StefanSaier-FSM/PowerBors-Wordclock/4_Dokumentation/Label/ReadMe.txt

Das Label kann mit dem Programm Nicelabel 10 gedruckt werden.
