StefanSaier-FSM/PowerBors-Wordclock/4_Dokumentation/Datasheets/PDV-P8104/Online Link.txt

https://www.mouser.de/ProductDetail/Advanced-Photonix/PDV-P8104?qs=tlsG%2FOw5FFhNlJFnM8WslQ%3D%3D
