StefanSaier-FSM/PowerBors-Wordclock/4_Dokumentation/Datasheets/PT1000/Online Link.txt

https://www.mouser.de/ProductDetail/Heraeus-Nexensos/32208571?qs=MQgg6%252BVqoaOBHSlL4FSuWg%3D%3D
