StefanSaier-FSM/PowerBors-Wordclock/4_Dokumentation/Label/Wordclock.png

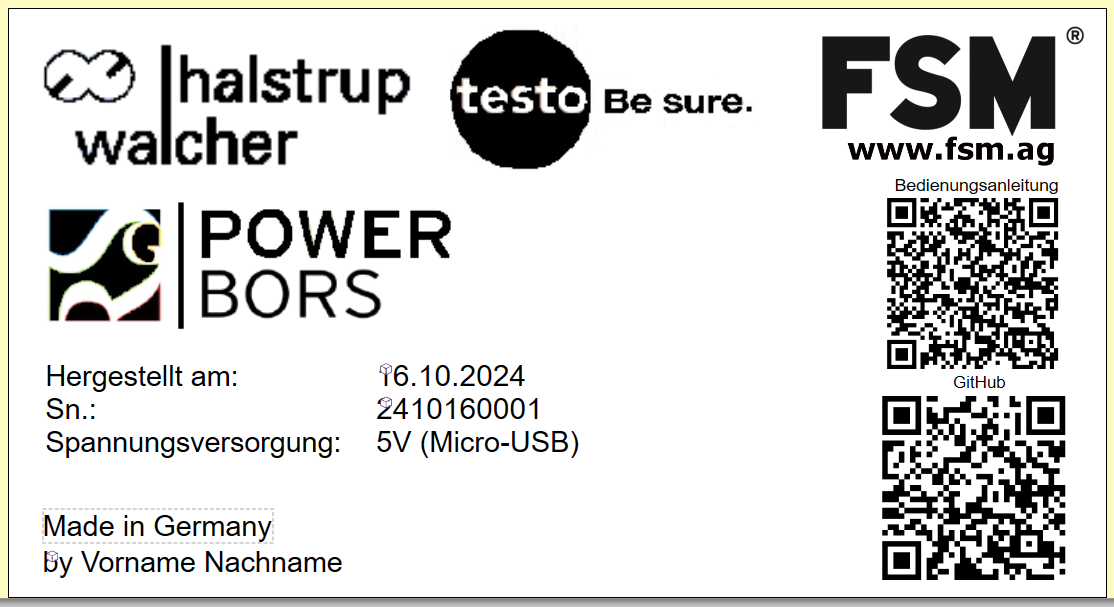
4_Dokumentation/Label/Wordclock.png
