StefanSaier-FSM/PowerBors-Wordclock/1_PCB/17862V2 STL Component Calculation.xlsx

Sheet: BOM Report
Bill of Materials Costing
 |  | Word Clock
Project Number: |  | 17862
Version: |  | V2_1
Variant: |  | A Default
 |  |  | +49 7661 9855 0 |  | www.fsm.ag
Creation Date: | 01.08.2024 | 10:57
Print Date: | 2024-08-01 | 10:57:05
Name: | M.Faller
 |  |  |  |  |  | Stock | Unit Price | Total Price
FSM Part Number | Quantity | Designator | Comment | Footprint | Mounting Technology | Supplier Stock 1 | Supplier Unit Price 1
30096001 | 114 | C0, C1, C2, C3, C4, C5, C6, C7, C8, C9, C10, C11, C12, C13, C14, C15, C16, C17, C18, C19, C20, C21, C22, C23, C24, C25, C26, C27, C28, C29, C30, C31, C32, C33, C34, C35, C36, C37, C38, C39, C40, C41, C42, C43, C44, C45, C46, C47, C48, C49, C50, C51, C52, C53, C54, C55, C56, C57, C58, C59, C60, C61, C62, C63, C64, C65, C66, C67, C68, C69, C70, C71, C72, C73, C74, C75, C76, C77, C78, C79, C80, C81, C82, C83, C84, C85, C86, C87, C88, C89, C90, C91, C92, C93, C94, C95, C96, C97, C98, C99, C100, C101, C102, C103, C104, C105, C106, C107, C108, C109, C110, C111, C112, C113 | 100n | C1206 | SMT | 0 |  | 0.00
30339601 | 2 | C114, C116 | 100n | C_THT_RM5.08_L7_B4 | THT |  |  | 0.00
xxxxxx01 | 2 | C115, C117 | 1µ | C_THT_RM5.08_L7_B4 | THT |  |  | 0.00
30045701 | 2 | D1, D4 | 1N4004 | DO-41_RM10.16_THT | THT | 0 |  | 0.00
40136001 | 2 | D2, D3 | 1N4448 | DO-35_RM10.16_THT_RED | THT | 0 |  | 0.00
30097701 | 2 | IC2, IC4 | LM317TG | TO220-3 THT | THT |  |  | 0.00
30031401 | 2 | IC3, IC6 | LM358N | PDIP8 THT | THT | 0 |  | 0.00
30426601 | 2 | R1, R9 | 2K | R_THT_RM10.16 | THT |  |  | 0.00
30002501 | 2 | R2, R10 | 2k21 | R_THT_RM10.16 | THT | 0 |  | 0.00
30045601 | 3 | R3, R15, R16 | 1k | R_THT_RM10.16 | THT |  |  | 0.00
30005301 | 1 | R4 | BQ7721603 | RJ-5EW | THT | 0 |  | 0.00
30037201 | 4 | R5, R6, R7, R14 | 10k | R_THT_RM10.16 | THT |  |  | 0.00
30019501 | 1 | R8 | 10k | R_THT_RM10.16 | THT |  |  | 0.00
30xxxx01 | 1 | R11 | BQ7721603 | LDR | THT | 0 |  | 0.00
30xxxx01 | 1 | R12 | BQ7721603 | PT1000 | THT | 0 |  | 0.00
30005101 | 1 | R13 | 2K | RJ-5EW | THT |  |  | 0.00
30xxxx01 | 2 | S1, S2 | BQ7721603 | Schiebeschalter THT 0S202011MA0QN1 | THT | 0 |  | 0.00
30738801 | 1 | ST1 | USB-A 87583-2010 | ST_USB_87583-2010 | SMT |  |  | 0.00
30445401 | 2 | ST2, ST4 | ST_1Pol_30212_AWG16_ROT | ST_1Pol_THT_SP_AWG16 | THT | 0 |  | 0.00
30066301 | 1 | ST3 | TSW-104-07-F-S | ST_SL_2_54_4Pol_THT | THT |  |  | 0.00
30527001 | 1 | ST5 | USB-B Micro | ST_USB_629105136821 | SMT |  |  | 0.00
30279101 | 3 | SW1, SW2, SW3 | SKHLLFA010 | SW_SKHL_6x3.5mm | THT |  |  | 0.00
 | 152 | Total Number of Components |  |  |  |  | Total Price | 0.00
 | 22 | Total Number of Different Components

Sheet: Project Information
Project Full Path | W:\Ausbildung\Technische Ausbildungsprojekte\17862_Wordclock\PowerBors\2_CAD\V2\PCB_Project_WordClock.PrjPcb
Project Filename | PCB_Project_WordClock.PrjPcb
Variant Name | A Default
Data-Source Filename | PCB_Project_WordClock.PrjPcb
Data-Source Full Path | W:\Ausbildung\Technische Ausbildungsprojekte\17862_Wordclock\PowerBors\2_CAD\V2\PCB_Project_WordClock.PrjPcb
Title | STL Component Calculation for Variant [A Default] of Project [PCB_Project_WordClock.PrjPcb] (No PCB Document Selected)
Total Quantity | 290
Report Time | 10:57
Report Date | 01.08.2024
Report Date & Tine | 01.08.2024 10:57
Output Name | STL Component Calculation
Output Type | BomReport
Output Generator Name | BOM
Output Generator Description | Bill of Materials
