StefanSaier-FSM/PowerBors-Wordclock/1_PCB/17862V2 STL Component Release.xlsx

Sheet: BOM Report
Component Release |  | Word Clock
Project Number: |  | 17862
Version: |  | V2_1
Variant: |  | A Default
 |  |  | +49 7661 9855 0 |  | www.fsm.ag
Creation Date: | 01.08.2024 | 10:56
Print Date: | 2024-08-01 | 10:56:58
Name: | M.Faller
 |  |  |  |  |  | ARAS Revision
FSM Part Number | Comment | Designator | Revision ID | Revision Status | Revision State | Supplier 1
30096001 | 100n | C0, C1, C2, C3, C4, C5, C6, C7, C8, C9, C10, C11, C12, C13, C14, C15, C16, C17, C18, C19, C20, C21, C22, C23, C24, C25, C26, C27, C28, C29, C30, C31, C32, C33, C34, C35, C36, C37, C38, C39, C40, C41, C42, C43, C44, C45, C46, C47, C48, C49, C50, C51, C52, C53, C54, C55, C56, C57, C58, C59, C60, C61, C62, C63, C64, C65, C66, C67, C68, C69, C70, C71, C72, C73, C74, C75, C76, C77, C78, C79, C80, C81, C82, C83, C84, C85, C86, C87, C88, C89, C90, C91, C92, C93, C94, C95, C96, C97, C98, C99, C100, C101, C102, C103, C104, C105, C106, C107, C108, C109, C110, C111, C112, C113 | CMP-02-0052-1_1_1 | Up to date | Released
30339601 | 100n | C114, C116 | CMP-02-0229-1_1_2 | Up to date | Preliminary
xxxxxx01 | 1µ | C115, C117 | CMP-02-0123-1_1_1 | Up to date | Preliminary
30045701 | 1N4004 | D1, D4 | CMP-04-0105-1_1_1 | Up to date | Preliminary
40136001 | 1N4448 | D2, D3 | CMP-04-0087-1_1_2 | Up to date | Preliminary
 | BQ7721603 | IC1 | CMP-11-0377-1_1_1 | Out of date | Preliminary
30097701 | LM317TG | IC2, IC4 | CMP-11-0225-1_1_1 | Up to date | Preliminary
30031401 | LM358N | IC3, IC6 | CMP-11-0330-1_1_2 | Up to date | Preliminary
70000001 | BQ7721603 | LED0, LED1, LED2, LED3, LED4, LED5, LED6, LED7, LED8, LED9, LED10, LED11, LED12, LED13, LED14, LED15, LED16, LED17, LED18, LED19, LED20, LED21, LED22, LED23, LED24, LED25, LED26, LED27, LED28, LED29, LED30, LED31, LED32, LED33, LED34, LED35, LED36, LED37, LED38, LED39, LED40, LED41, LED42, LED43, LED44, LED45, LED46, LED47, LED48, LED49, LED50, LED51, LED52, LED53, LED54, LED55, LED56, LED57, LED58, LED59, LED60, LED61, LED62, LED63, LED64, LED65, LED66, LED67, LED68, LED69, LED70, LED71, LED72, LED73, LED74, LED75, LED76, LED77, LED78, LED79, LED80, LED81, LED82, LED83, LED84, LED85, LED86, LED87, LED88, LED89, LED90, LED91, LED92, LED93, LED94, LED95, LED96, LED97, LED98, LED99, LED100, LED101, LED102, LED103, LED104, LED105, LED106, LED107, LED108, LED109 | CMP-11-0377-1_1_2 | Up to date | Review
 | BQ7721603 | LED110, LED111, LED112, LED113 | CMP-11-0377-1_1_2 | Up to date | Review
30426601 | 2K | R1, R9 | CMP-01-0583-1_1_3 | Up to date | Preliminary
30002501 | 2k21 | R2, R10 | CMP-01-0580-1_1_3 | Up to date | Preliminary
30045601 | 1k | R3, R15, R16 | CMP-01-0585-1_1_4 | Up to date | Preliminary
30005301 | BQ7721603 | R4 | CMP-11-0377-1_1_1 | Out of date | Preliminary
30037201 | 10k | R5, R6, R7, R14 | CMP-01-0584-1_1_4 | Up to date | Preliminary
30019501 | 10k | R8 | CMP-01-0584-1_1_4 | Up to date | Preliminary
30xxxx01 | BQ7721603 | R11 | CMP-11-0377-1_1_1 | Out of date | Preliminary
30xxxx01 | BQ7721603 | R12 | CMP-11-0377-1_1_1 | Out of date | Preliminary
30005101 | 2K | R13 |  |  | Not managed
30xxxx01 | BQ7721603 | S1, S2 | CMP-11-0377-1_1_1 | Out of date | Preliminary
30738801 | USB-A 87583-2010 | ST1 | CMP-10-0369-1_1_3 | Up to date | Preliminary
30445401 | ST_1Pol_30212_AWG16_ROT | ST2, ST4 | CMP-10-0061-1_1_1 | Up to date | Preliminary
30066301 | TSW-104-07-F-S | ST3 | CMP-10-0368-1_1_3 | Up to date | Preliminary
30527001 | USB-B Micro | ST5 | CMP-10-0156-1_1_1 | Up to date | Preliminary
30279101 | SKHLLFA010 | SW1, SW2, SW3 | CMP-08-0027-1_1_3 | Up to date | Preliminary
nb | TP 3mm | TP1, TP2, TP3, TP4, TP5, TP6, TP7, TP8, TP10, TP11, TP12, TP13, TP14, TP15, TP16, TP17, TP18, TP19, TP20, TP21, TP22, TP23, TP24 | CMP-12-0027-1_1_2 | Up to date | Released

Sheet: Project Information
Project Full Path | W:\Ausbildung\Technische Ausbildungsprojekte\17862_Wordclock\PowerBors\2_CAD\V2\PCB_Project_WordClock.PrjPcb
Project Filename | PCB_Project_WordClock.PrjPcb
Variant Name | A Default
Data-Source Filename | PCB_Project_WordClock.PrjPcb
Data-Source Full Path | W:\Ausbildung\Technische Ausbildungsprojekte\17862_Wordclock\PowerBors\2_CAD\V2\PCB_Project_WordClock.PrjPcb
Title | STL Component Release for Variant [A Default] of Project [PCB_Project_WordClock.PrjPcb] (No PCB Document Selected)
Total Quantity | 290
Report Time | 10:56
Report Date | 01.08.2024
Report Date & Tine | 01.08.2024 10:56
Output Name | STL Component Release
Output Type | BomReport
Output Generator Name | BOM
Output Generator Description | Bill of Materials
