StefanSaier-FSM/PowerBors-Wordclock/1_PCB/17862V2 STL THT.xlsx

Sheet: BOM Report
Bill of Materials |  | Word Clock
Project Number: |  | 17862
Version: |  | V2_1
Variant: |  | A Default
 |  |  | +49 7661 9855 0 |  | www.fsm.ag
Creation Date: | 01.08.2024 | 10:56
Print Date: | 2024-08-01 | 10:56:49
Name: | M.Faller
FSM Part Number | Quantity | Designator | Comment | Footprint | Mounting Technology
30339601 | 2 | C114, C116 | 100n | C_THT_RM5.08_L7_B4 | THT
xxxxxx01 | 2 | C115, C117 | 47µ | C_THT_RM5.08_L7_B4 | THT
30045701 | 2 | D1, D4 | 1N4004 | DO-41_RM10.16_THT | THT
40136001 | 2 | D2, D3 | 1N4448 | DO-35_RM10.16_THT_RED | THT
30097701 | 2 | IC2, IC4 | LM317TG | TO220-3 THT | THT
30031401 | 2 | IC3, IC6 | LM358N | PDIP8 THT | THT
30426601 | 2 | R1, R9 | 2K | R_THT_RM10.16 | THT
30002501 | 2 | R2, R10 | 2k21 | R_THT_RM10.16 | THT
30045601 | 3 | R3, R15, R16 | 1k | R_THT_RM10.16 | THT
30005301 | 1 | R4 | 10k | RJ-5EW | THT
30037201 | 4 | R5, R6, R7, R14 | 10k | R_THT_RM10.16 | THT
30019501 | 1 | R8 | 4k75 | R_THT_RM10.16 | THT
30xxxx01 | 1 | R11 | DS_PDV_P8104-2950677 | LDR | THT
30xxxx01 | 1 | R12 | PT1000 | PT1000 | THT
30005101 | 1 | R13 | 2K | RJ-5EW | THT
30xxxx01 | 2 | S1, S2 | 0S202011MA0QN1 | Schiebeschalter THT 0S202011MA0QN1 | THT
30445401 | 2 | ST2, ST4 | ST_1Pol_30212_AWG16_ROT | ST_1Pol_THT_SP_AWG16 | THT
30066301 | 1 | ST3 | TSW-104-07-F-S | ST_SL_2_54_4Pol_THT | THT
30279101 | 3 | SW1, SW2, SW3 | SKHLLFA010 | SW_SKHL_6x3.5mm | THT
 | 36 | Total Number of Components
 | 19 | Total Number of Different Components

Sheet: Project Information
Project Full Path | W:\Ausbildung\Technische Ausbildungsprojekte\17862_Wordclock\PowerBors\2_CAD\V2\PCB_Project_WordClock.PrjPcb
Project Filename | PCB_Project_WordClock.PrjPcb
Variant Name | A Default
Data-Source Filename | PCB_Project_WordClock.PrjPcb
Data-Source Full Path | W:\Ausbildung\Technische Ausbildungsprojekte\17862_Wordclock\PowerBors\2_CAD\V2\PCB_Project_WordClock.PrjPcb
Title | STL THT for Variant [A Default] of Project [PCB_Project_WordClock.PrjPcb] (No PCB Document Selected)
Total Quantity | 290
Report Time | 10:56
Report Date | 01.08.2024
Report Date & Tine | 01.08.2024 10:56
Output Name | STL THT
Output Type | BomReport
Output Generator Name | BOM
Output Generator Description | Bill of Materials
