StefanSaier-FSM/PowerBors-Wordclock/2_Konstruktion/Gehäuse_von_HT/V2/Einzelteile Wordclock/Gehäuseunterteil.stp

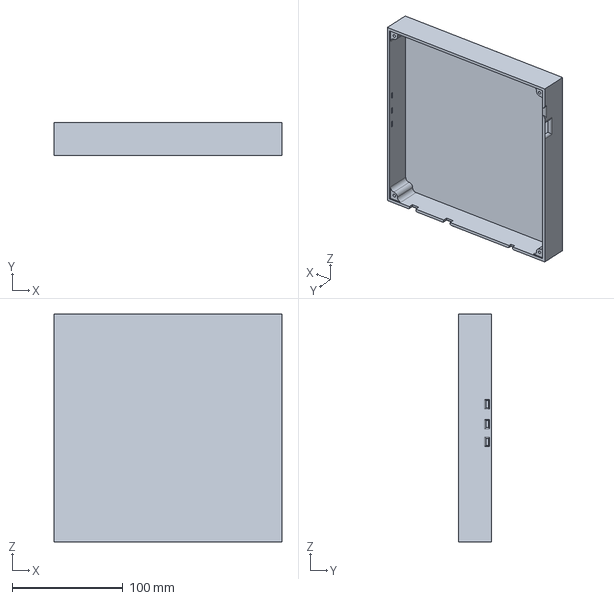
[picture p2: CAD file, 2024-08-01]
2_Konstruktion/Gehäuse_von_HT/V2/Einzelteile Wordclock/Gehäuseunterteil.stp
206.0 x 30.0 x 206.0 mm
