StefanSaier-FSM/PowerBors-Wordclock/2_Konstruktion/Gehäuse_von_HT/V2/Einzelteile Wordclock/Milchglas.stp

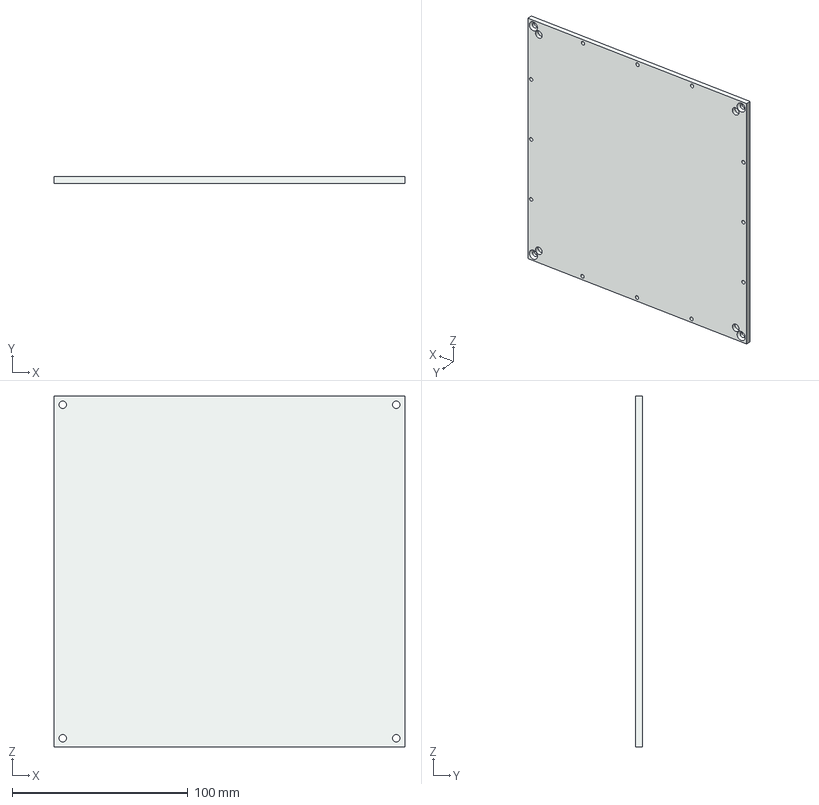
[picture p3: CAD file, 2024-08-01]
2_Konstruktion/Gehäuse_von_HT/V2/Einzelteile Wordclock/Milchglas.stp
200.0 x 4.00 x 200.0 mm
