StefanSaier-FSM/PowerBors-Wordclock/2_Konstruktion/Gehäuse_von_HT/V2/Einzelteile Wordclock/Abschirmung LED's.stp

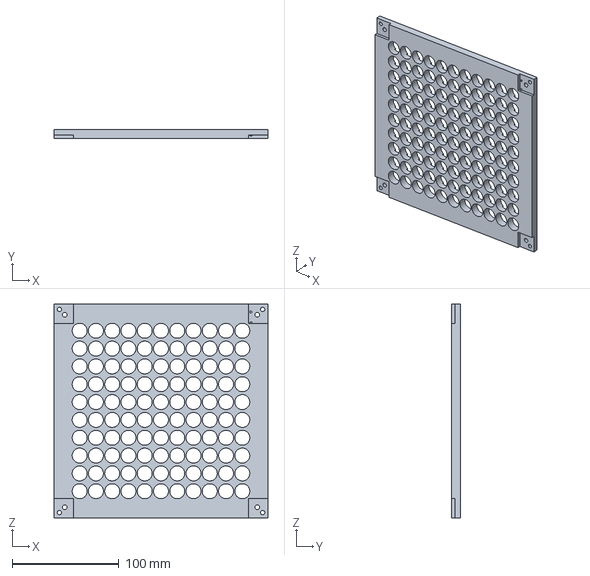
[picture p4: CAD file, 2024-08-01]
2_Konstruktion/Gehäuse_von_HT/V2/Einzelteile Wordclock/Abschirmung LED's.stp
200.0 x 8.00 x 200.0 mm
