StefanSaier-FSM/PowerBors-Wordclock/2_Konstruktion/Gehäuse_von_HT/V2/Einzelteile Wordclock/Frontplatte mit Stegen.stp

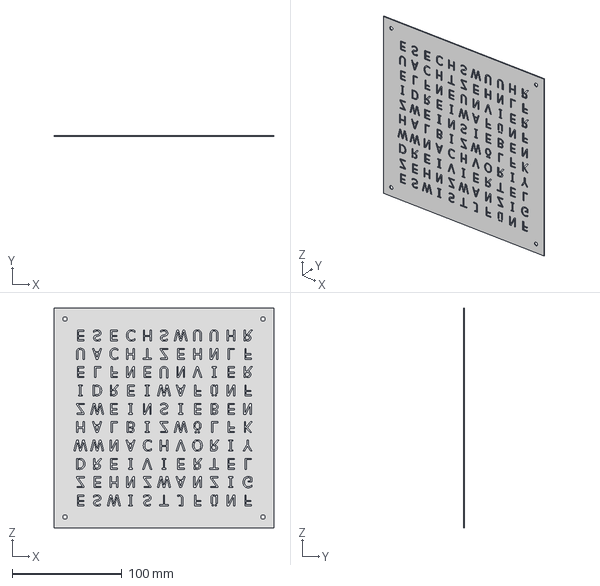
[picture p5: CAD file, 2024-08-01]
2_Konstruktion/Gehäuse_von_HT/V2/Einzelteile Wordclock/Frontplatte mit Stegen.stp
200.0 x 1.00 x 200.0 mm
