StefanSaier-FSM/PowerBors-Wordclock/2_Konstruktion/Gehäuse_von_HT/V1/Abschirmung LED's 200x200mm 12H.stp

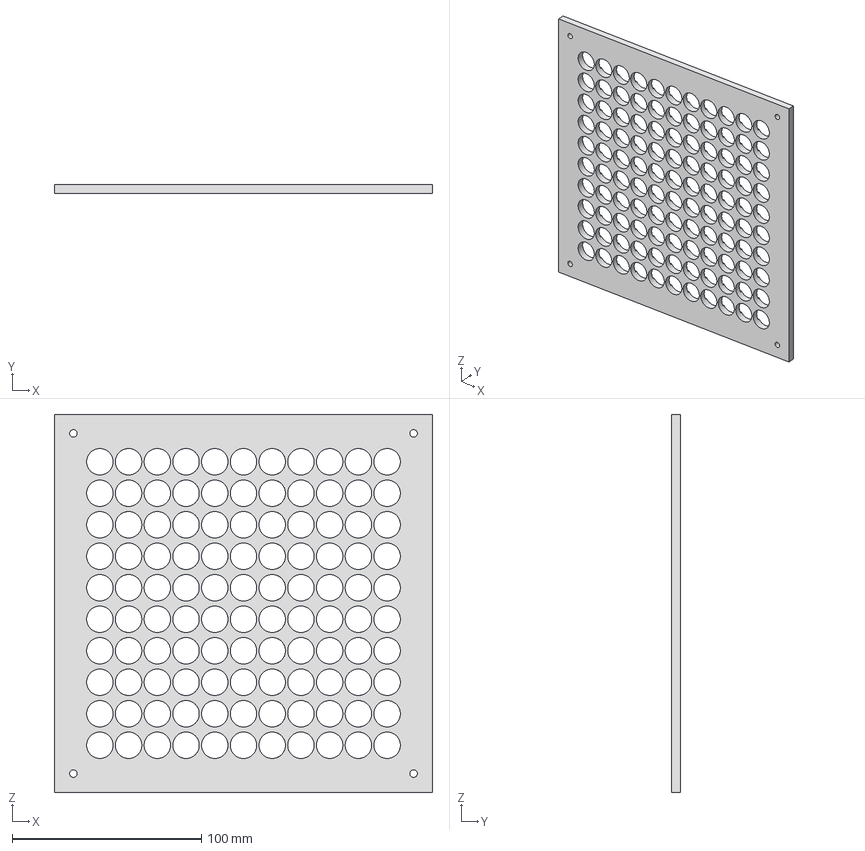
[picture p7: CAD file, 2024-08-01, an earlier design]
2_Konstruktion/Gehäuse_von_HT/V1/Abschirmung LED's 200x200mm 12H.stp
200.0 x 5.00 x 200.0 mm
