StefanSaier-FSM/PowerBors-Wordclock/(list of files, cad)

Other CAD files:
2_Konstruktion/Gehäuse_von_HT/V1/Wordclock_200x200mm_12H.stp
