StefanSaier-FSM/PowerBors-Wordclock/1_PCB/17862V2 PCB Print BOT.PDF

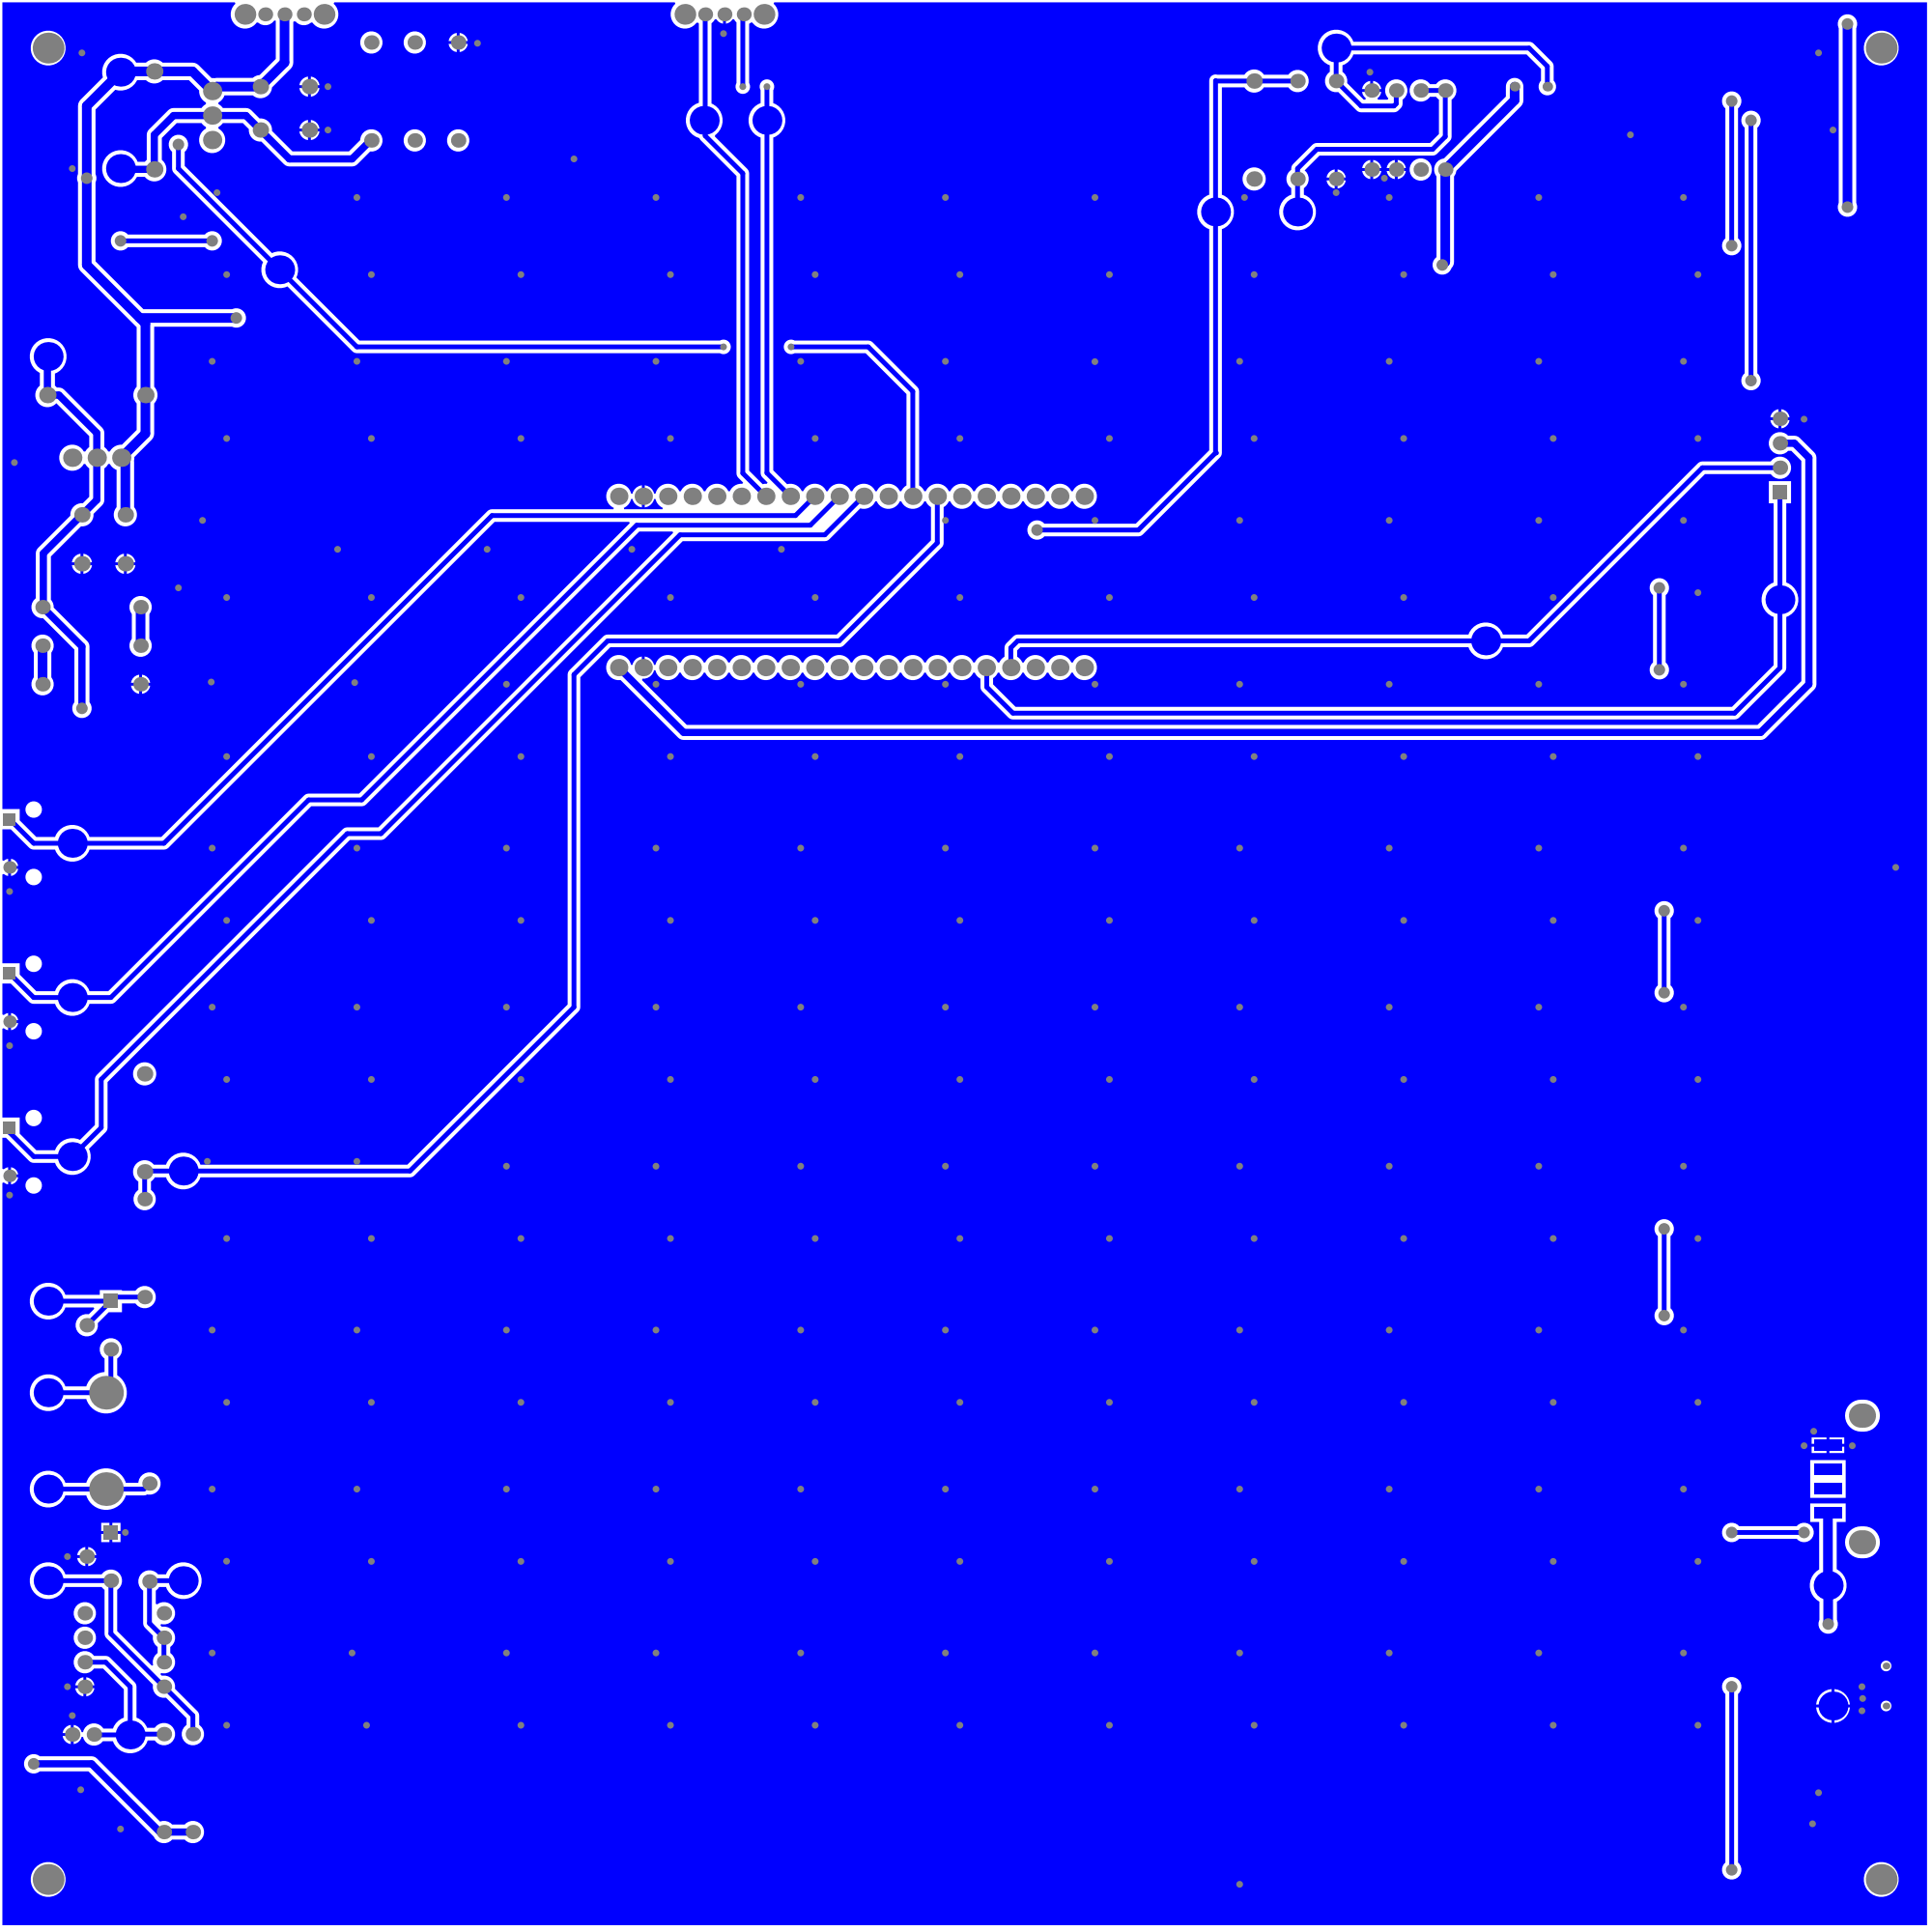
[picture p9: page 1]
