StefanSaier-FSM/PowerBors-Wordclock/1_PCB/17862V2 PCB Print TOP.PDF

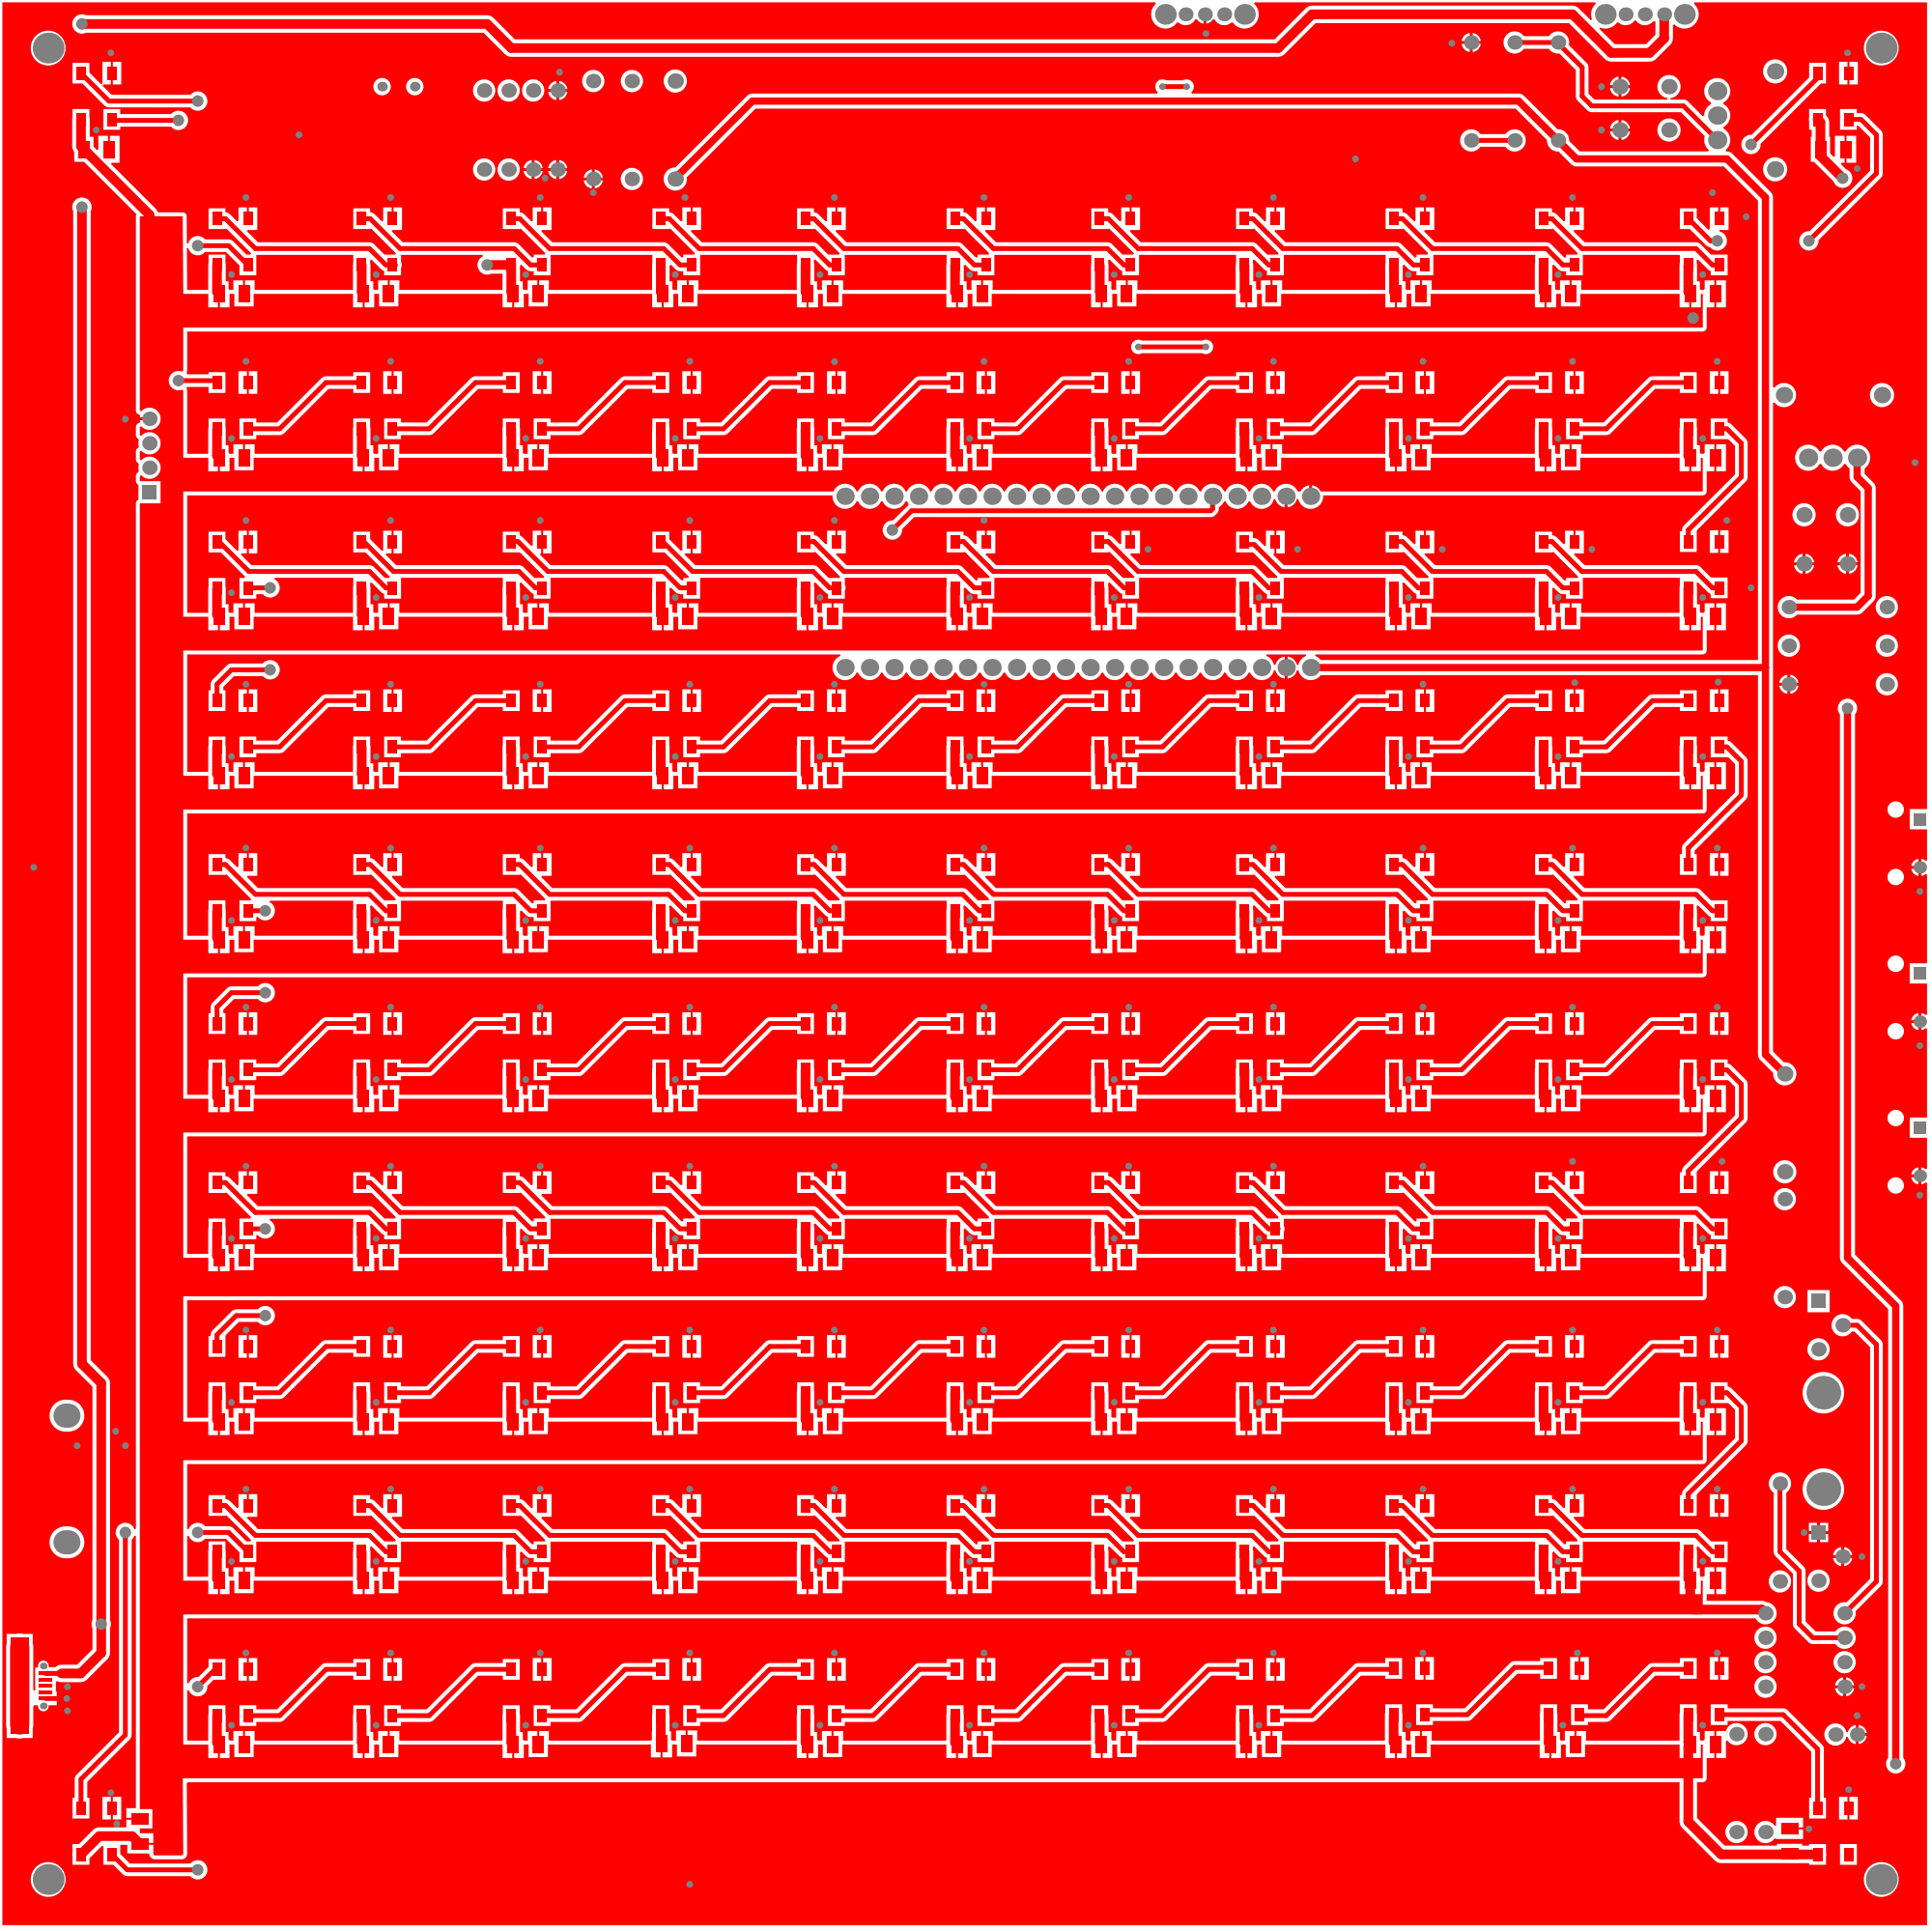
[picture p10: page 1]
