StefanSaier-FSM/PowerBors-Wordclock/1_PCB/17862V2 BSP BOT.PDF

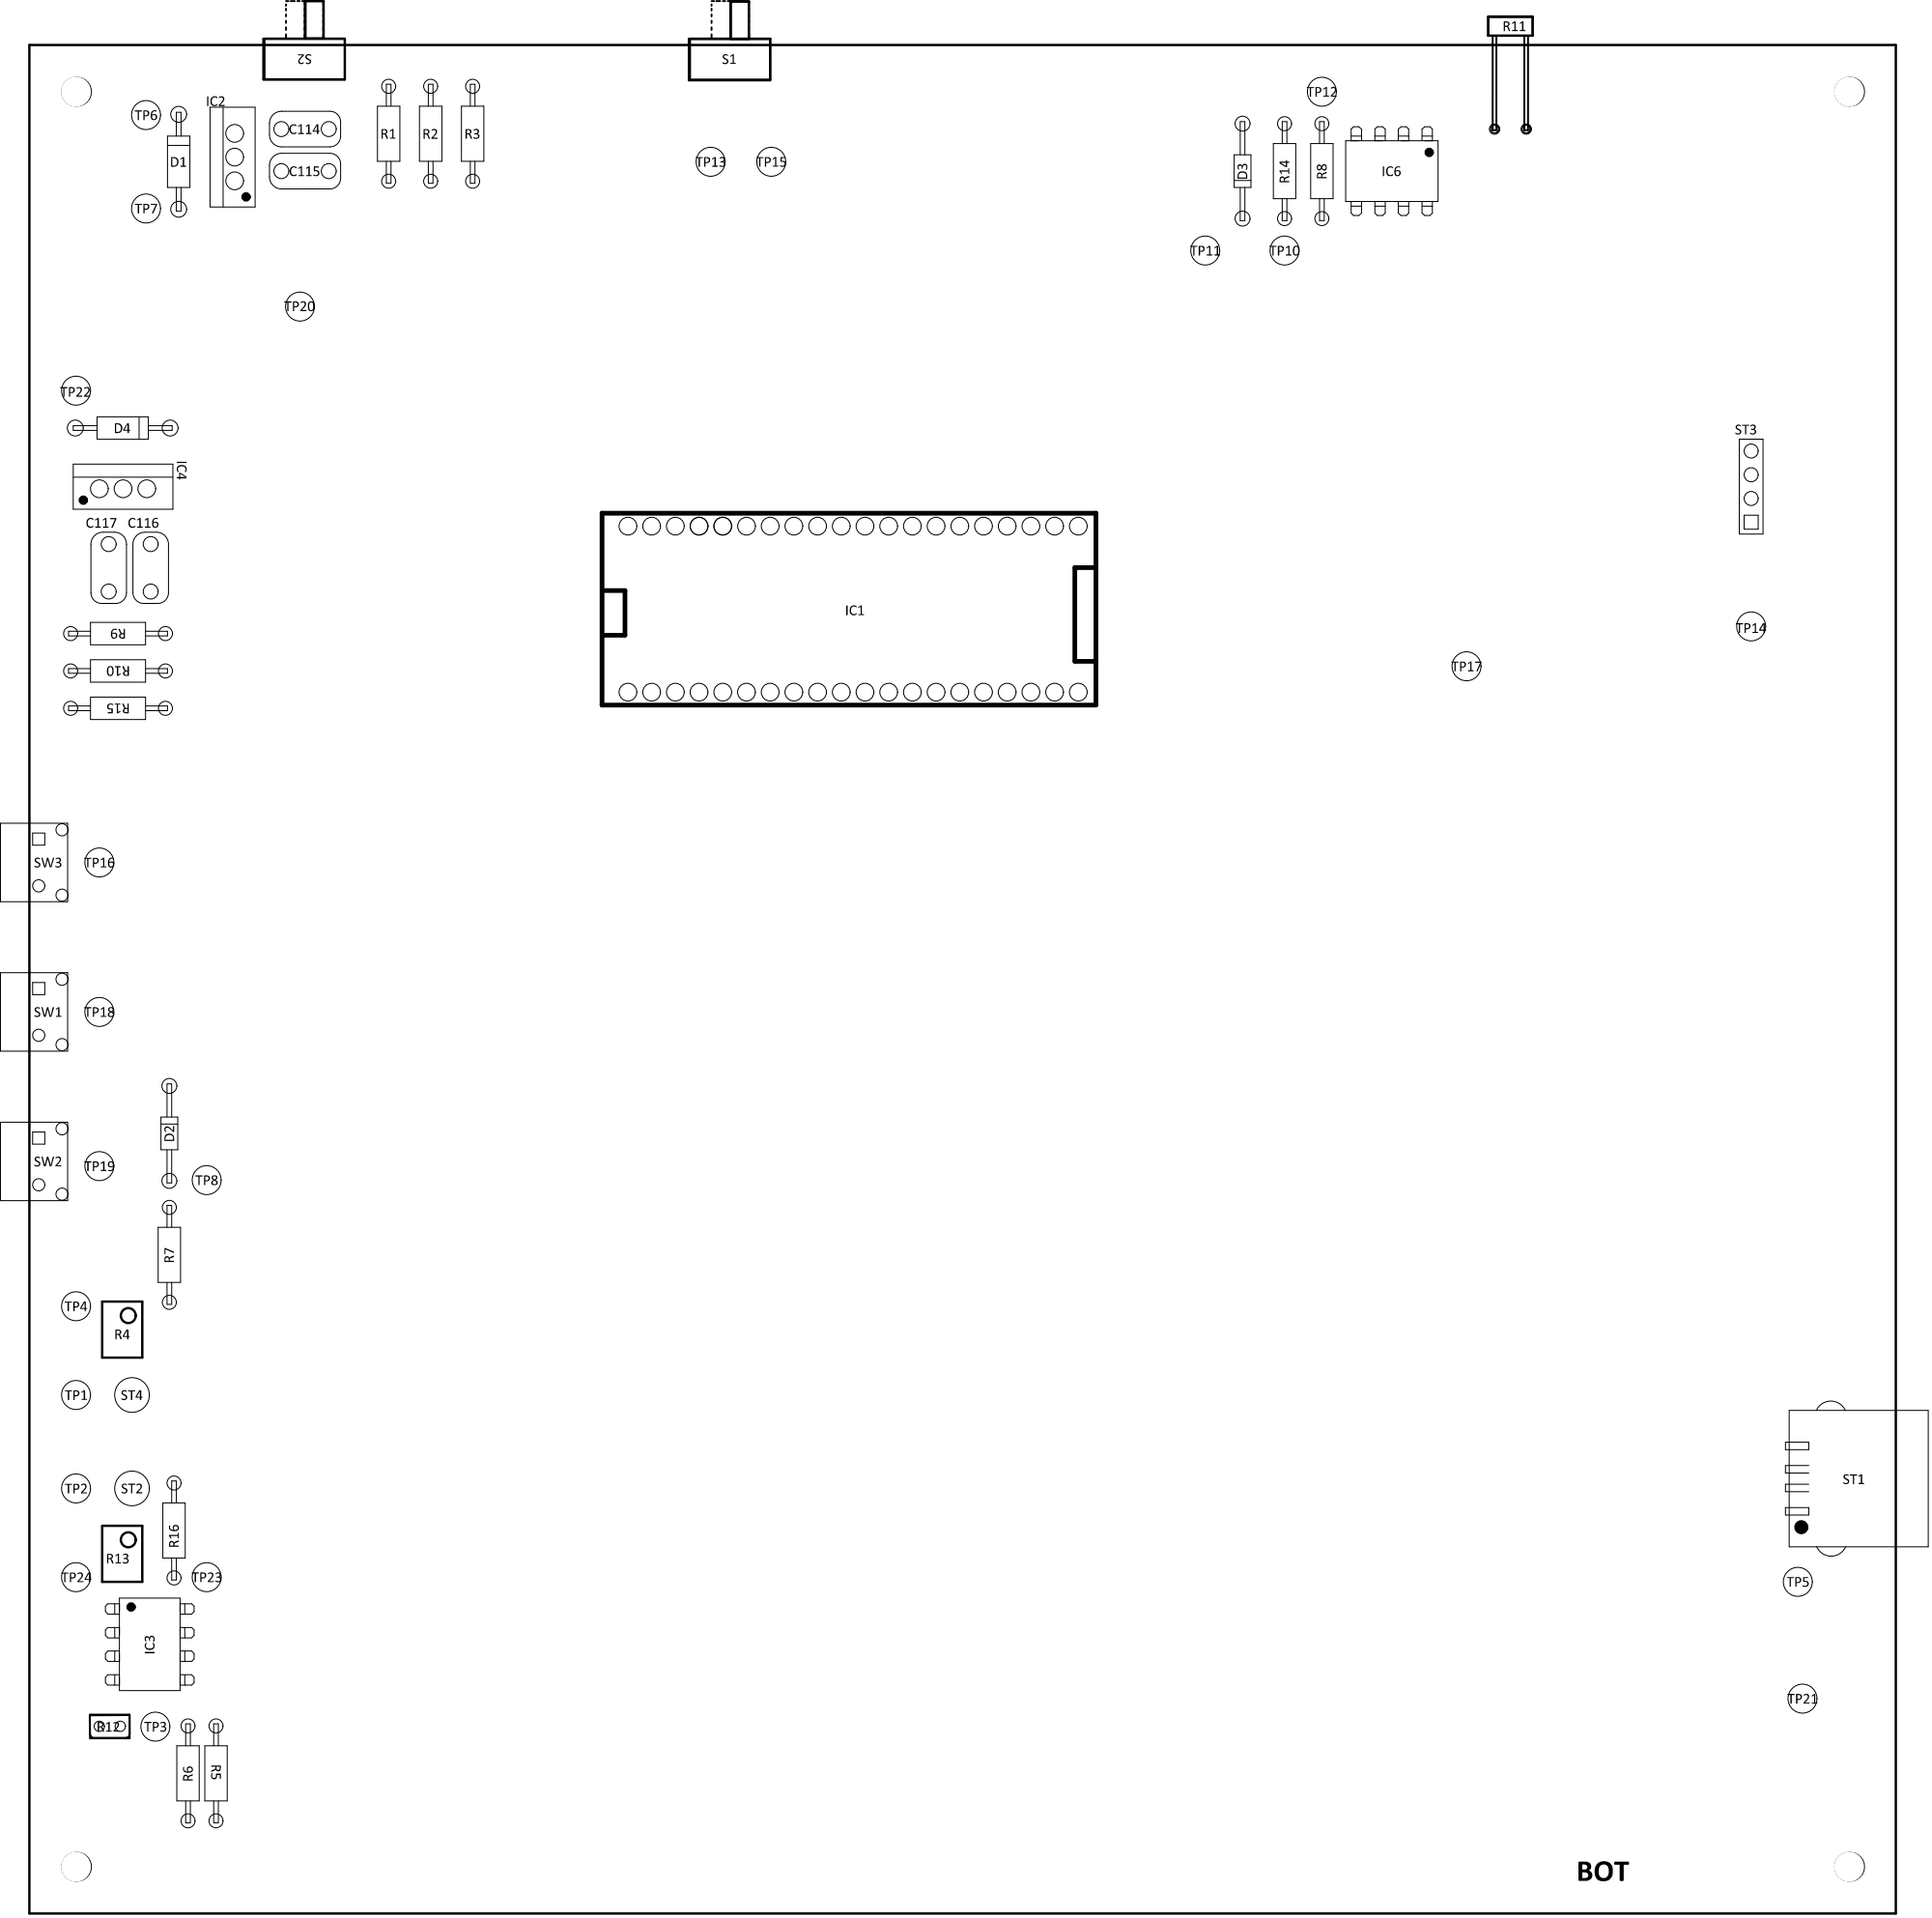
[picture p16: page 1]
