StefanSaier-FSM/PowerBors-Wordclock/1_PCB/17862V2 BSP TOP.PDF

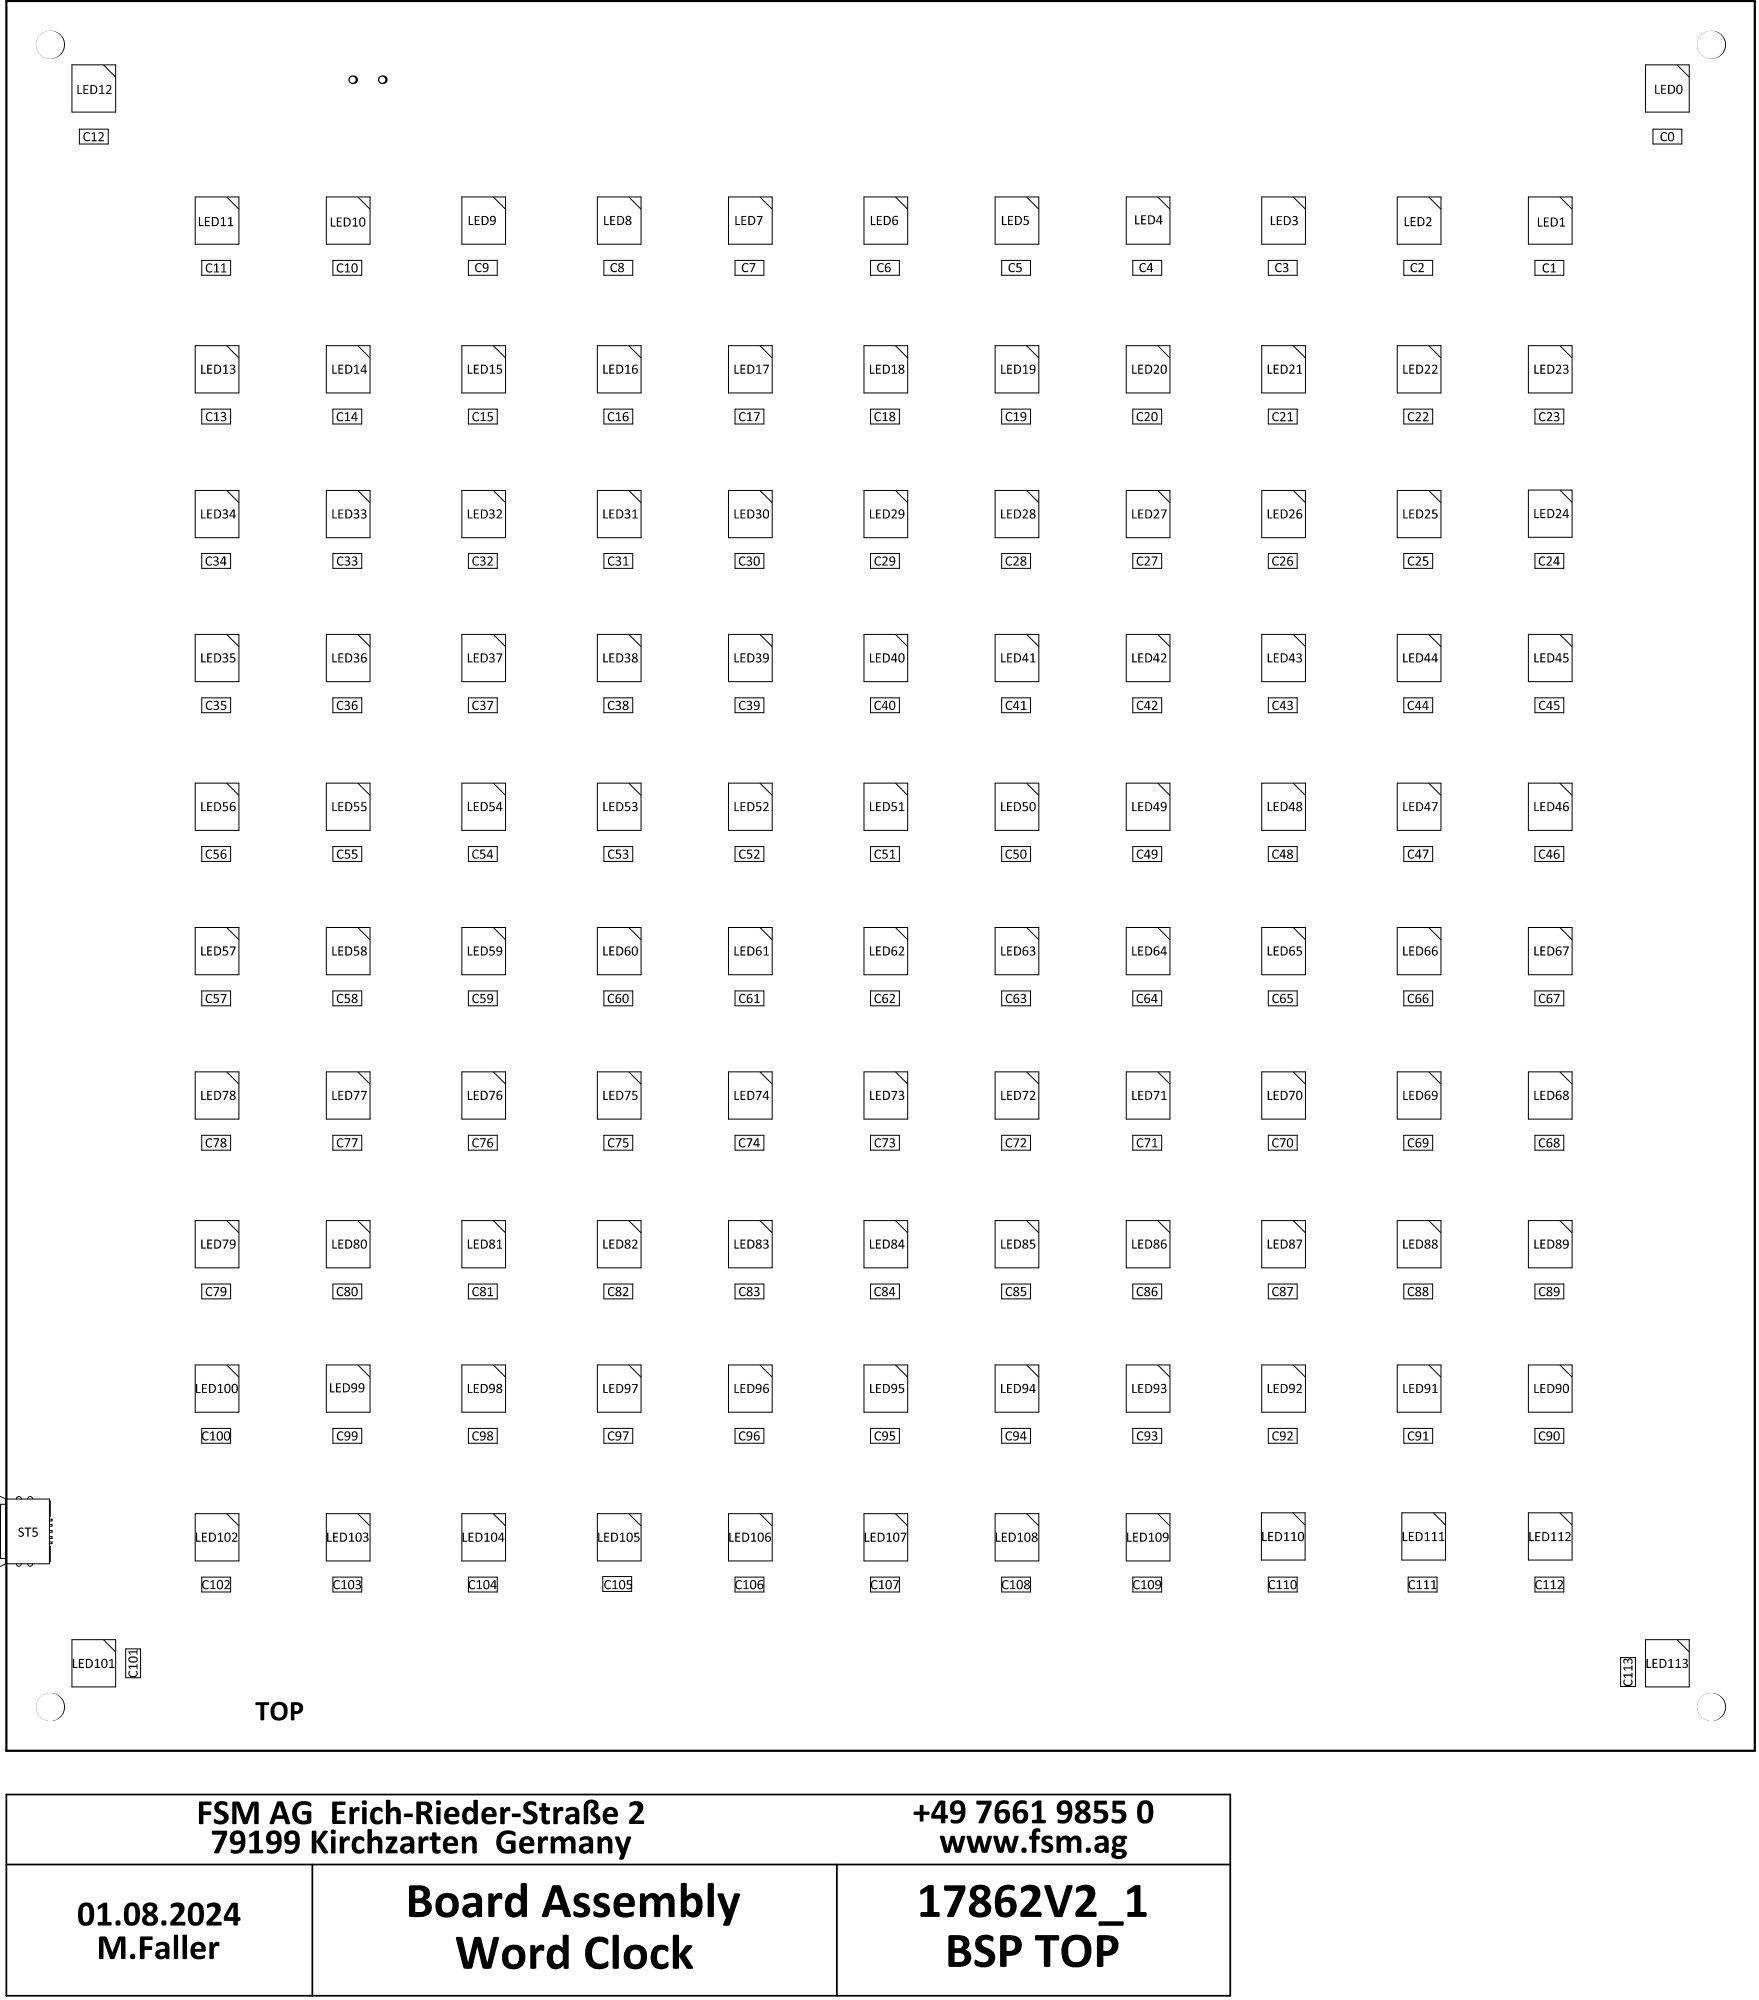
[picture p17: page 1]
