StefanSaier-FSM/PowerBors-Wordclock/1_PCB/17862V2 SLP.PDF

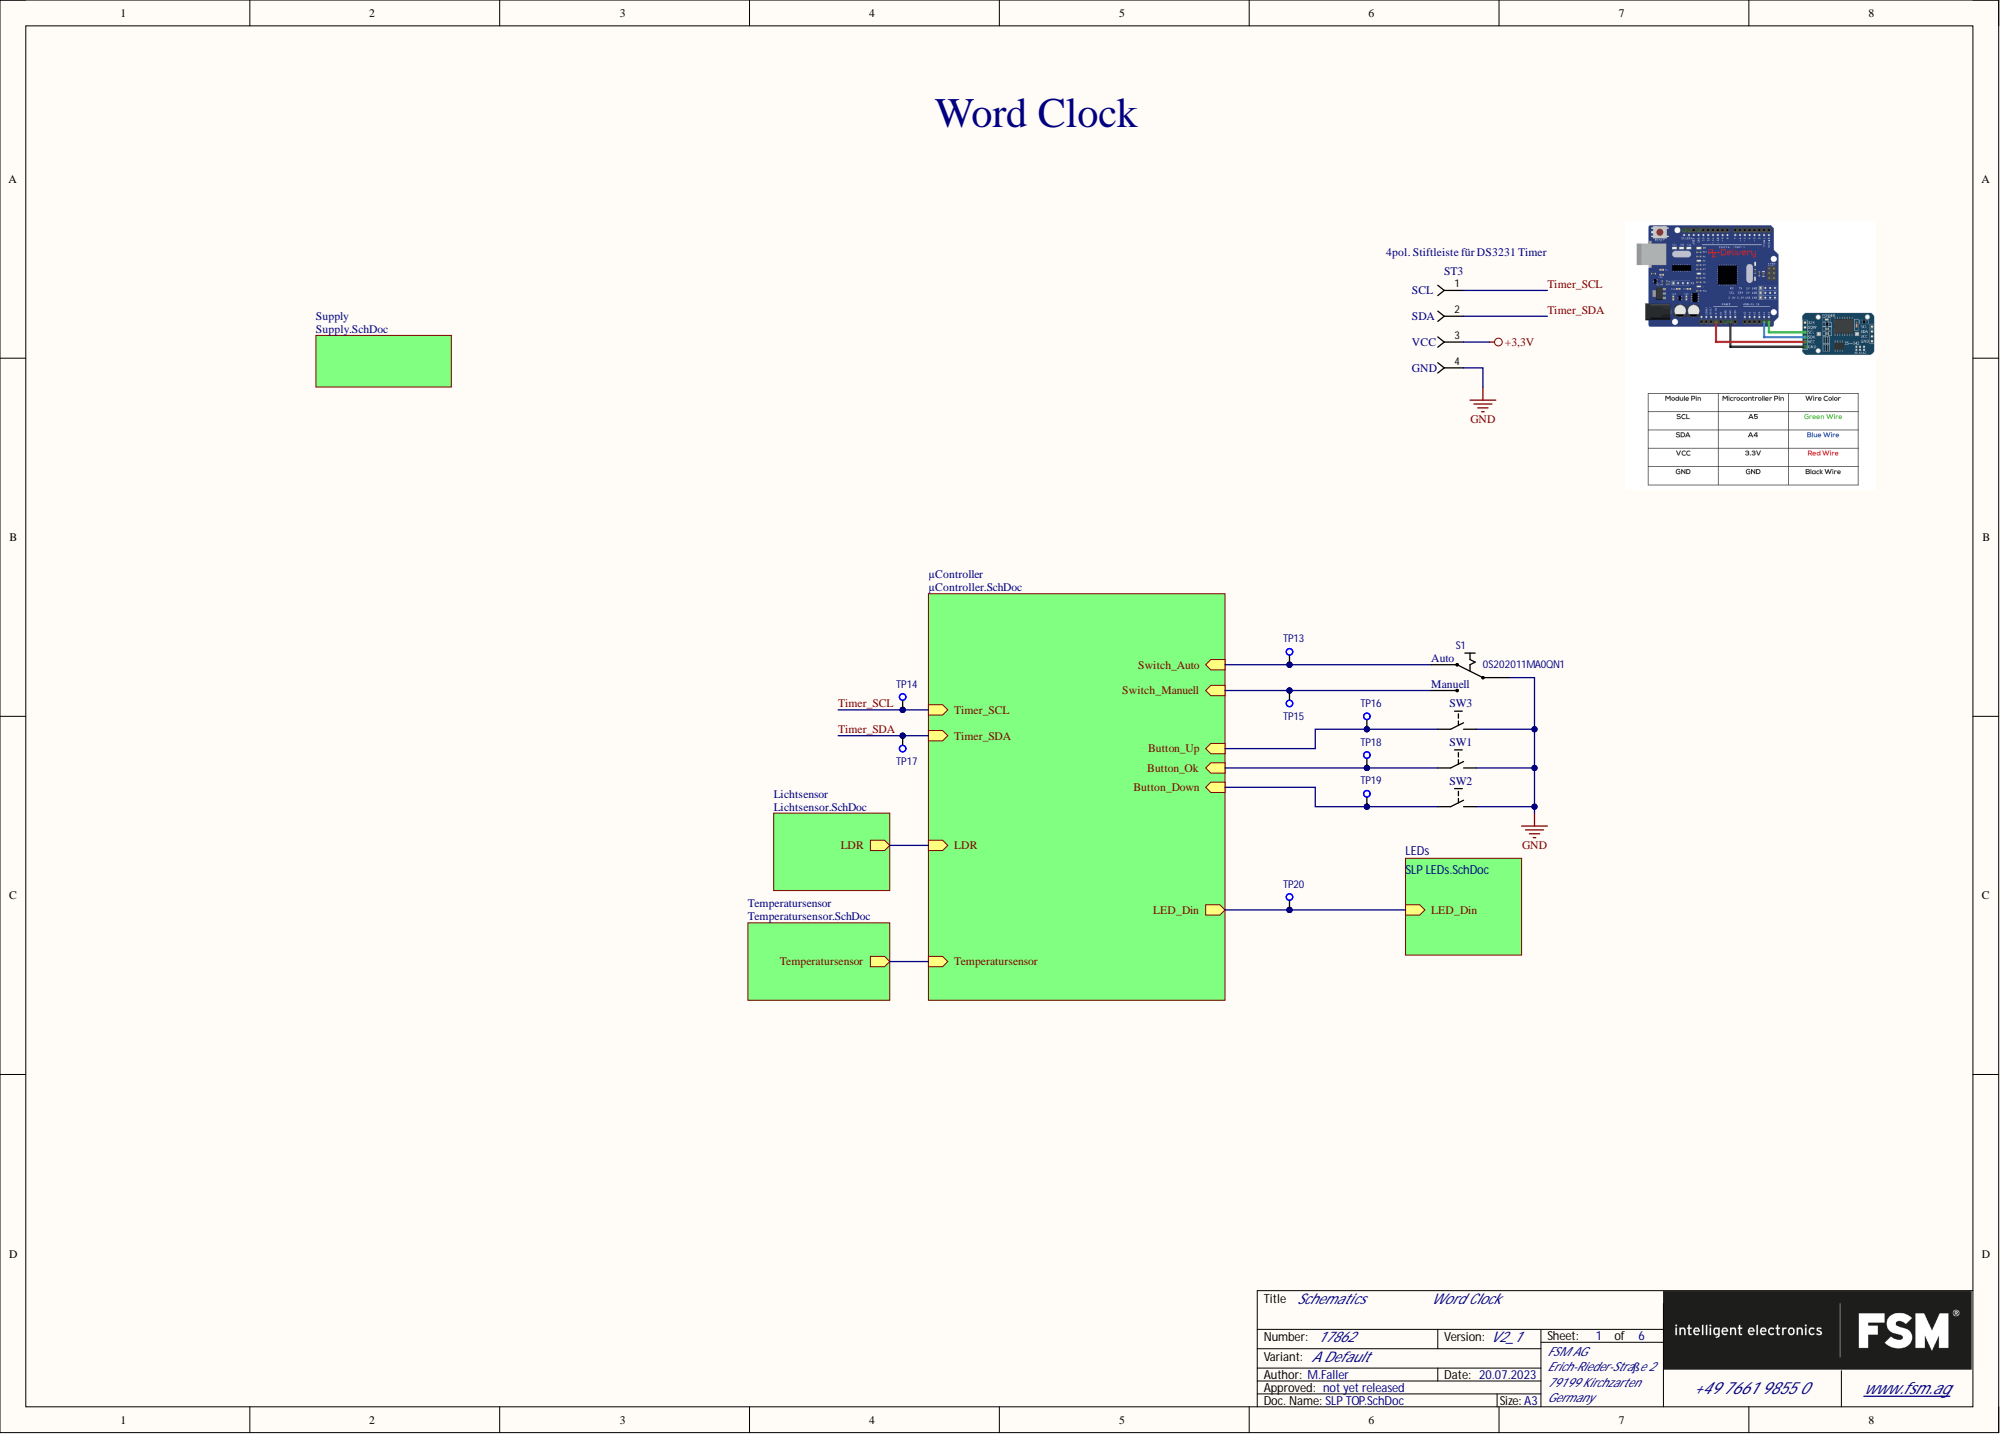
[picture p18: page 1]

Number:
Variant: A Default
Author: M.Faller
Approved: not yet released

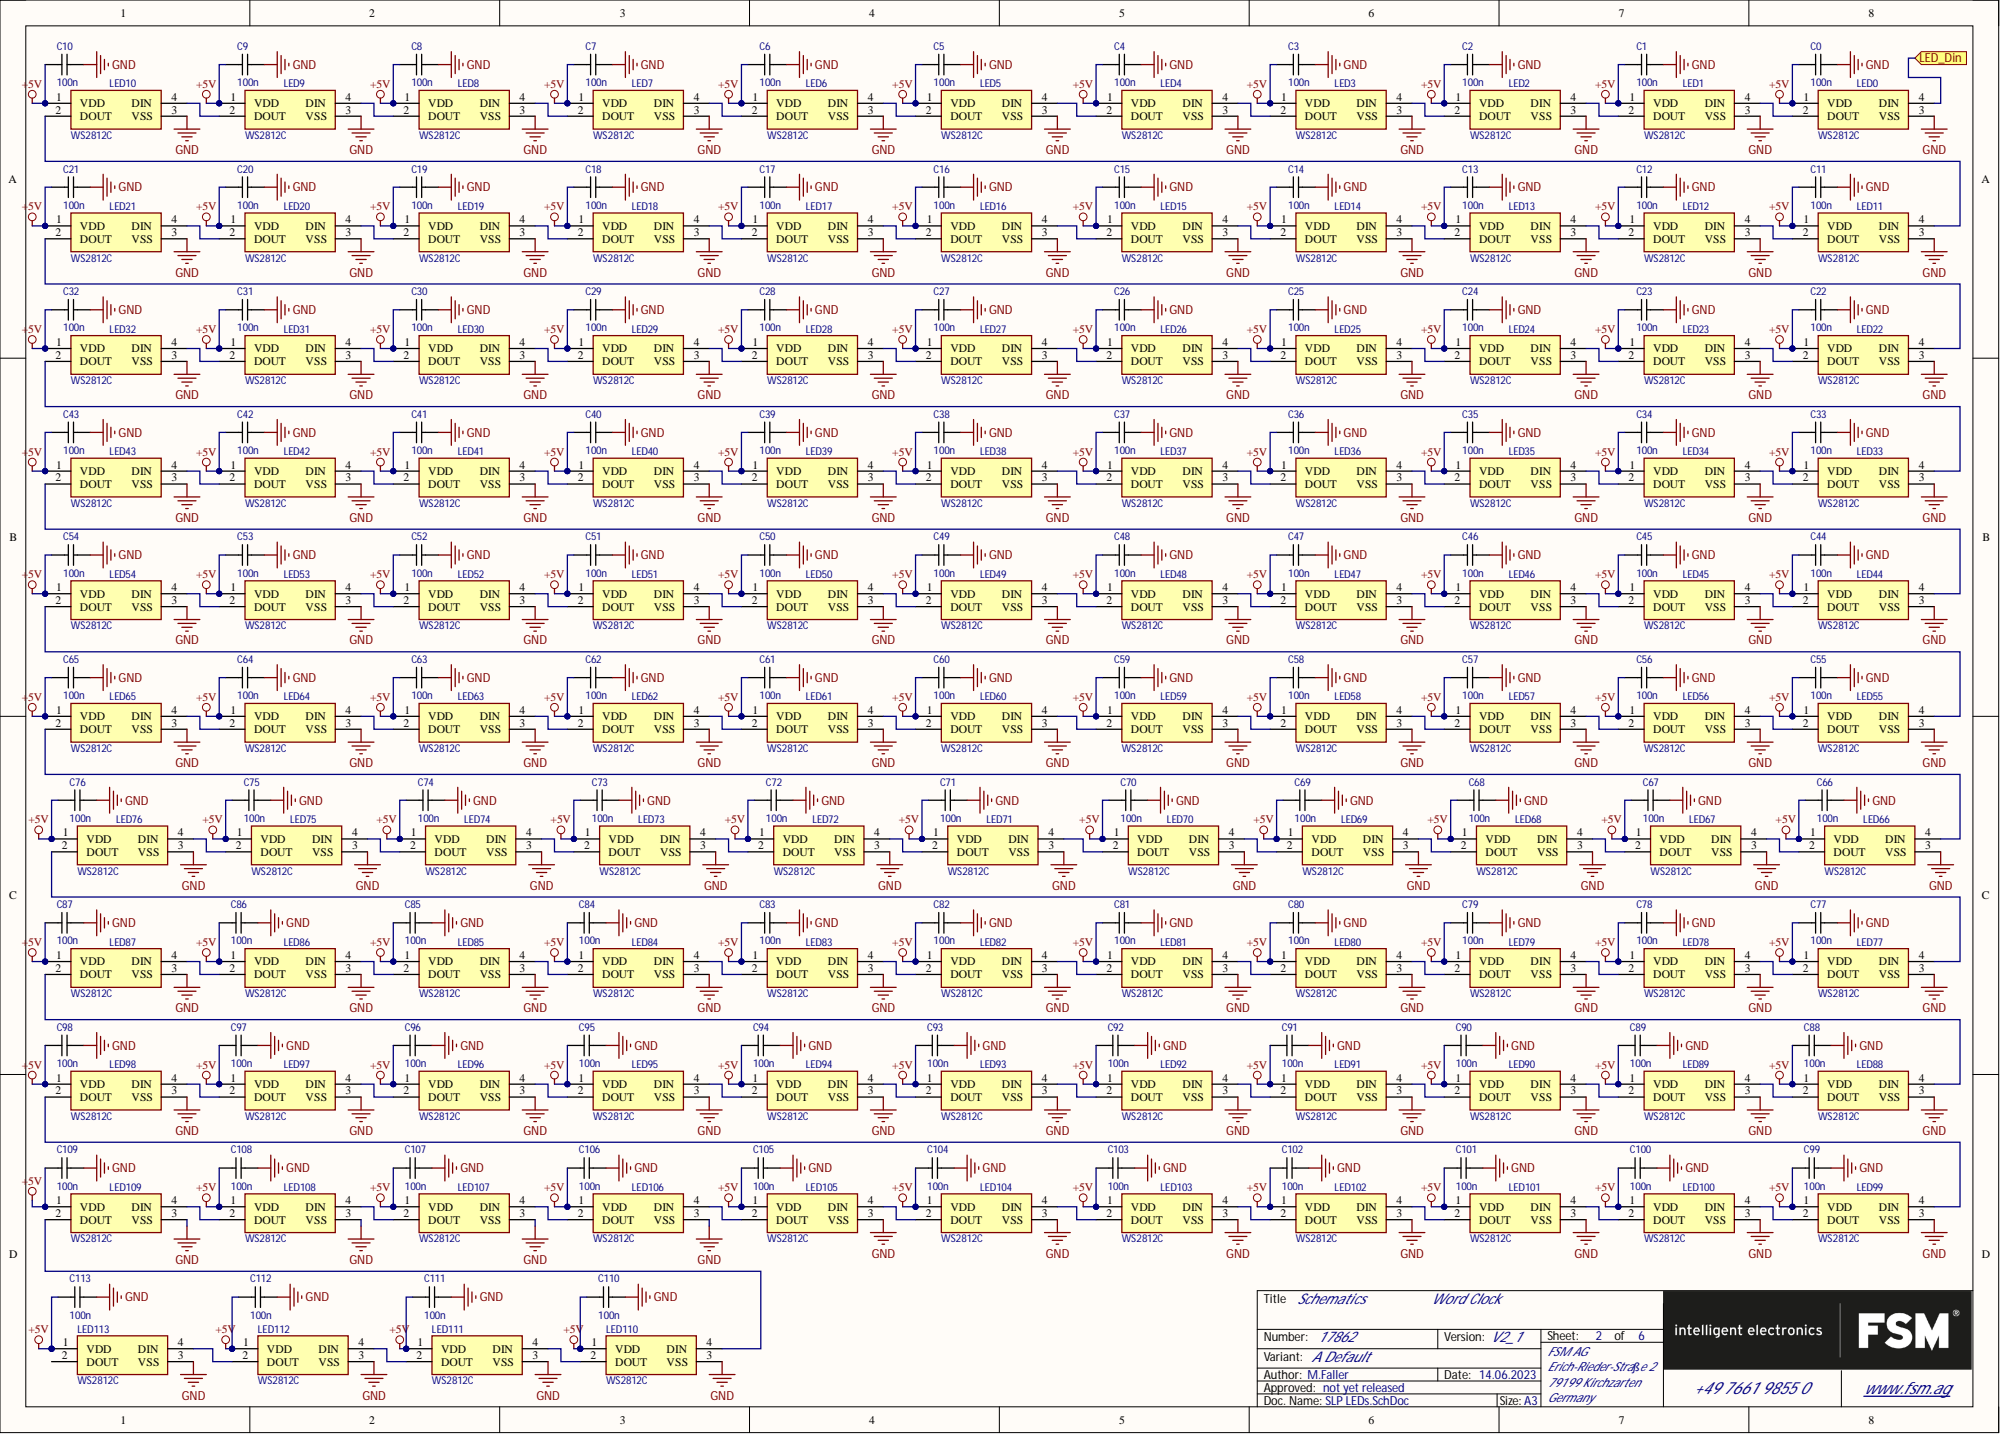
[picture p19: page 2]

DOUT 2 VSS | 3 DIN 4 | DOUT 2 VSS | 3 DIN 4 | DOUT 2 VSS | 3 DIN 4

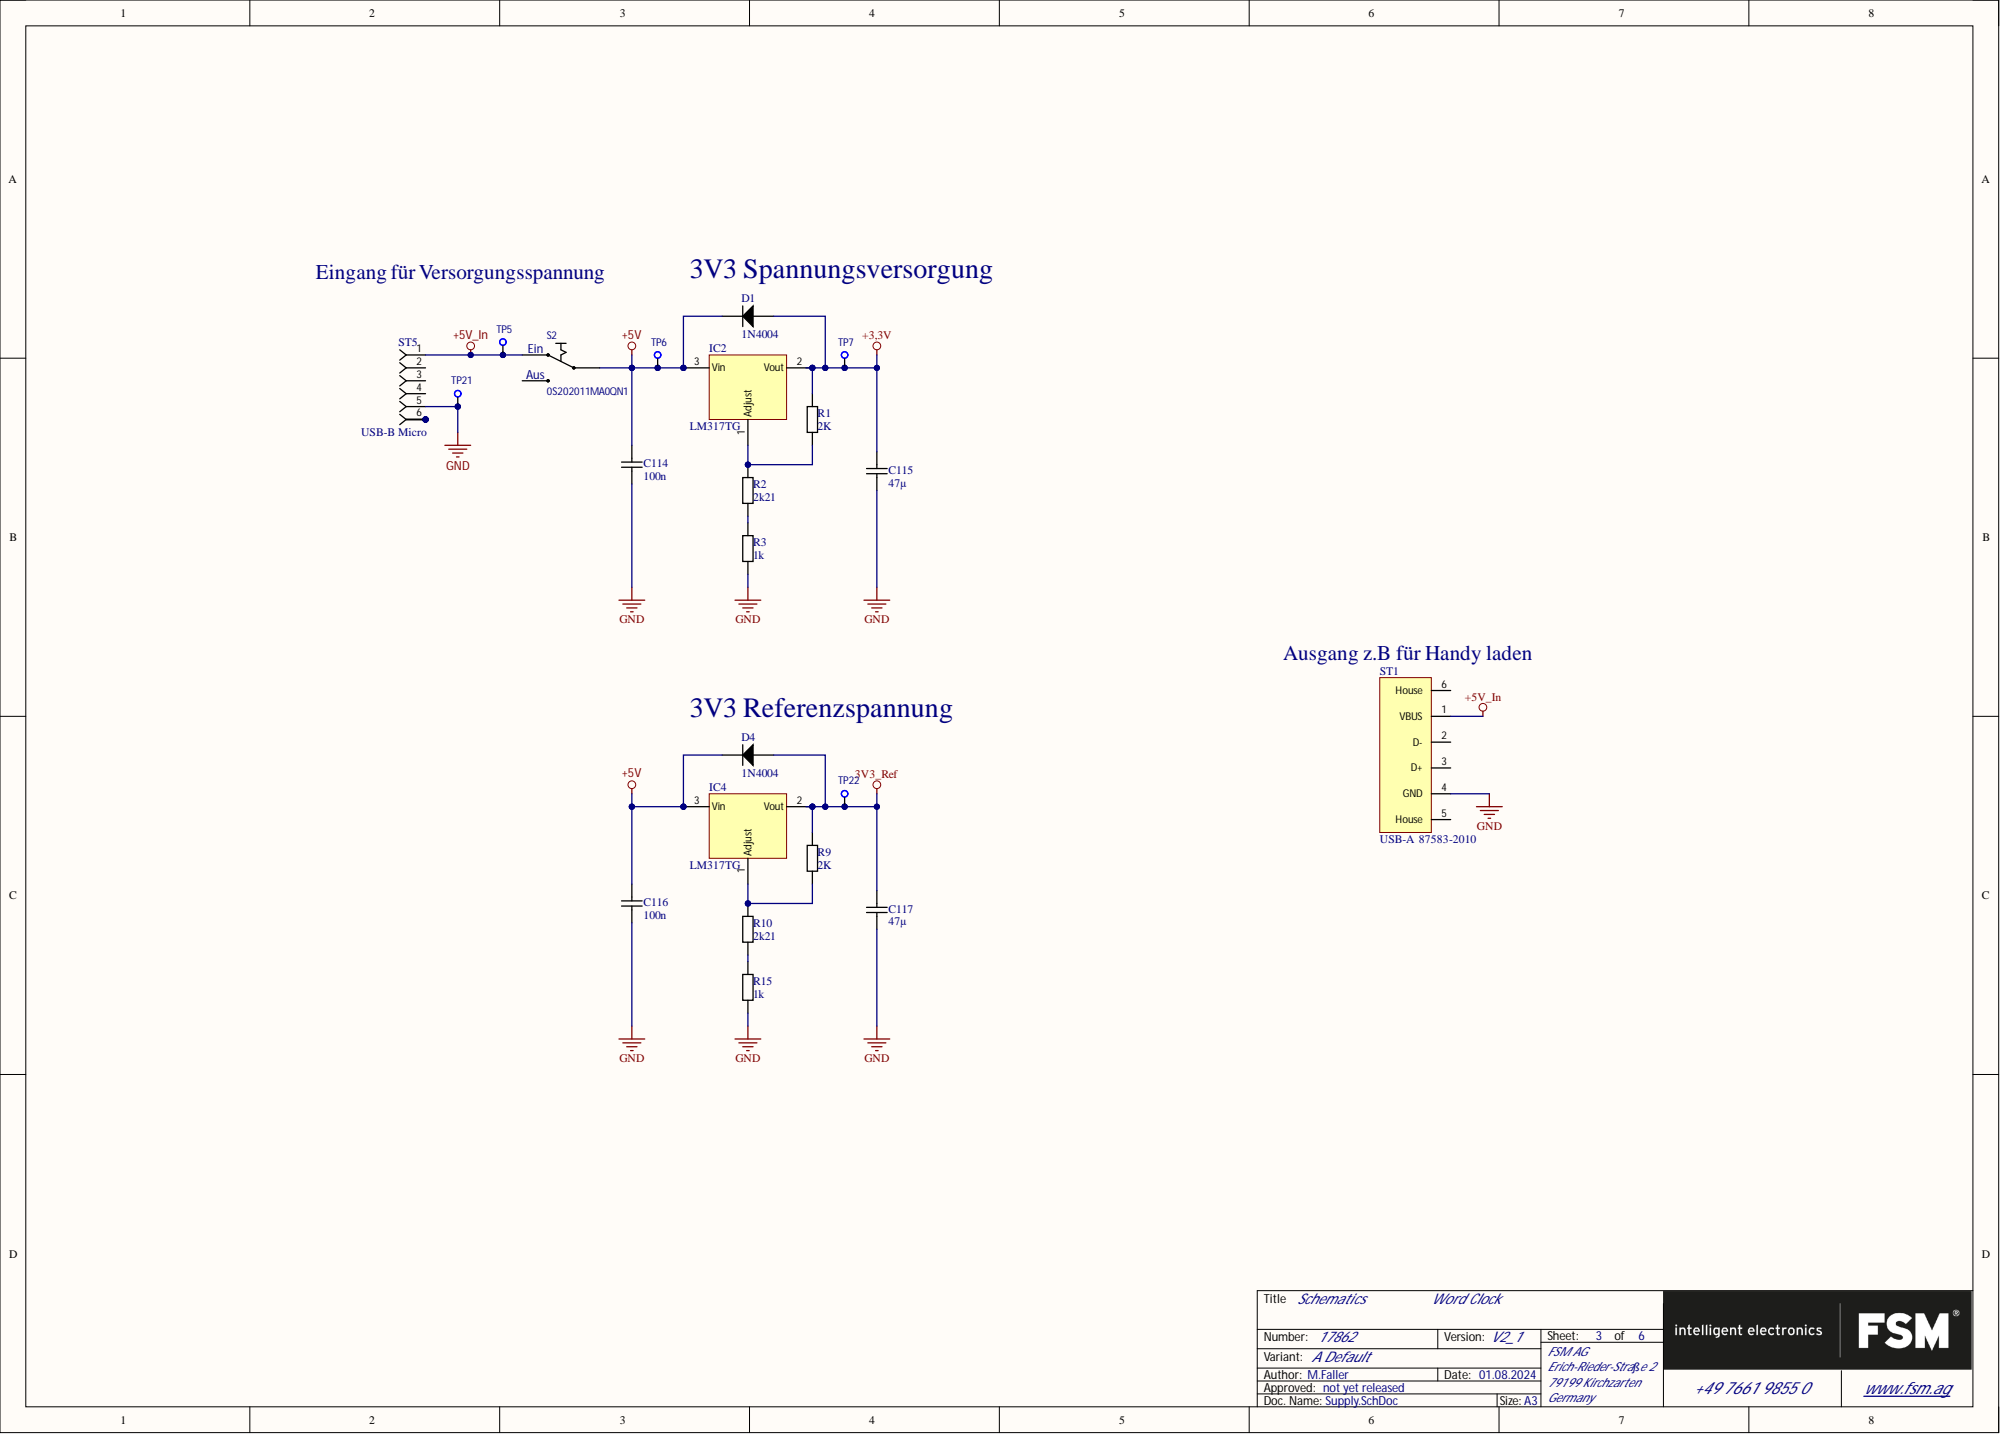
[picture p20: page 3]

Variant:
Author: M.
Approved: not yet re

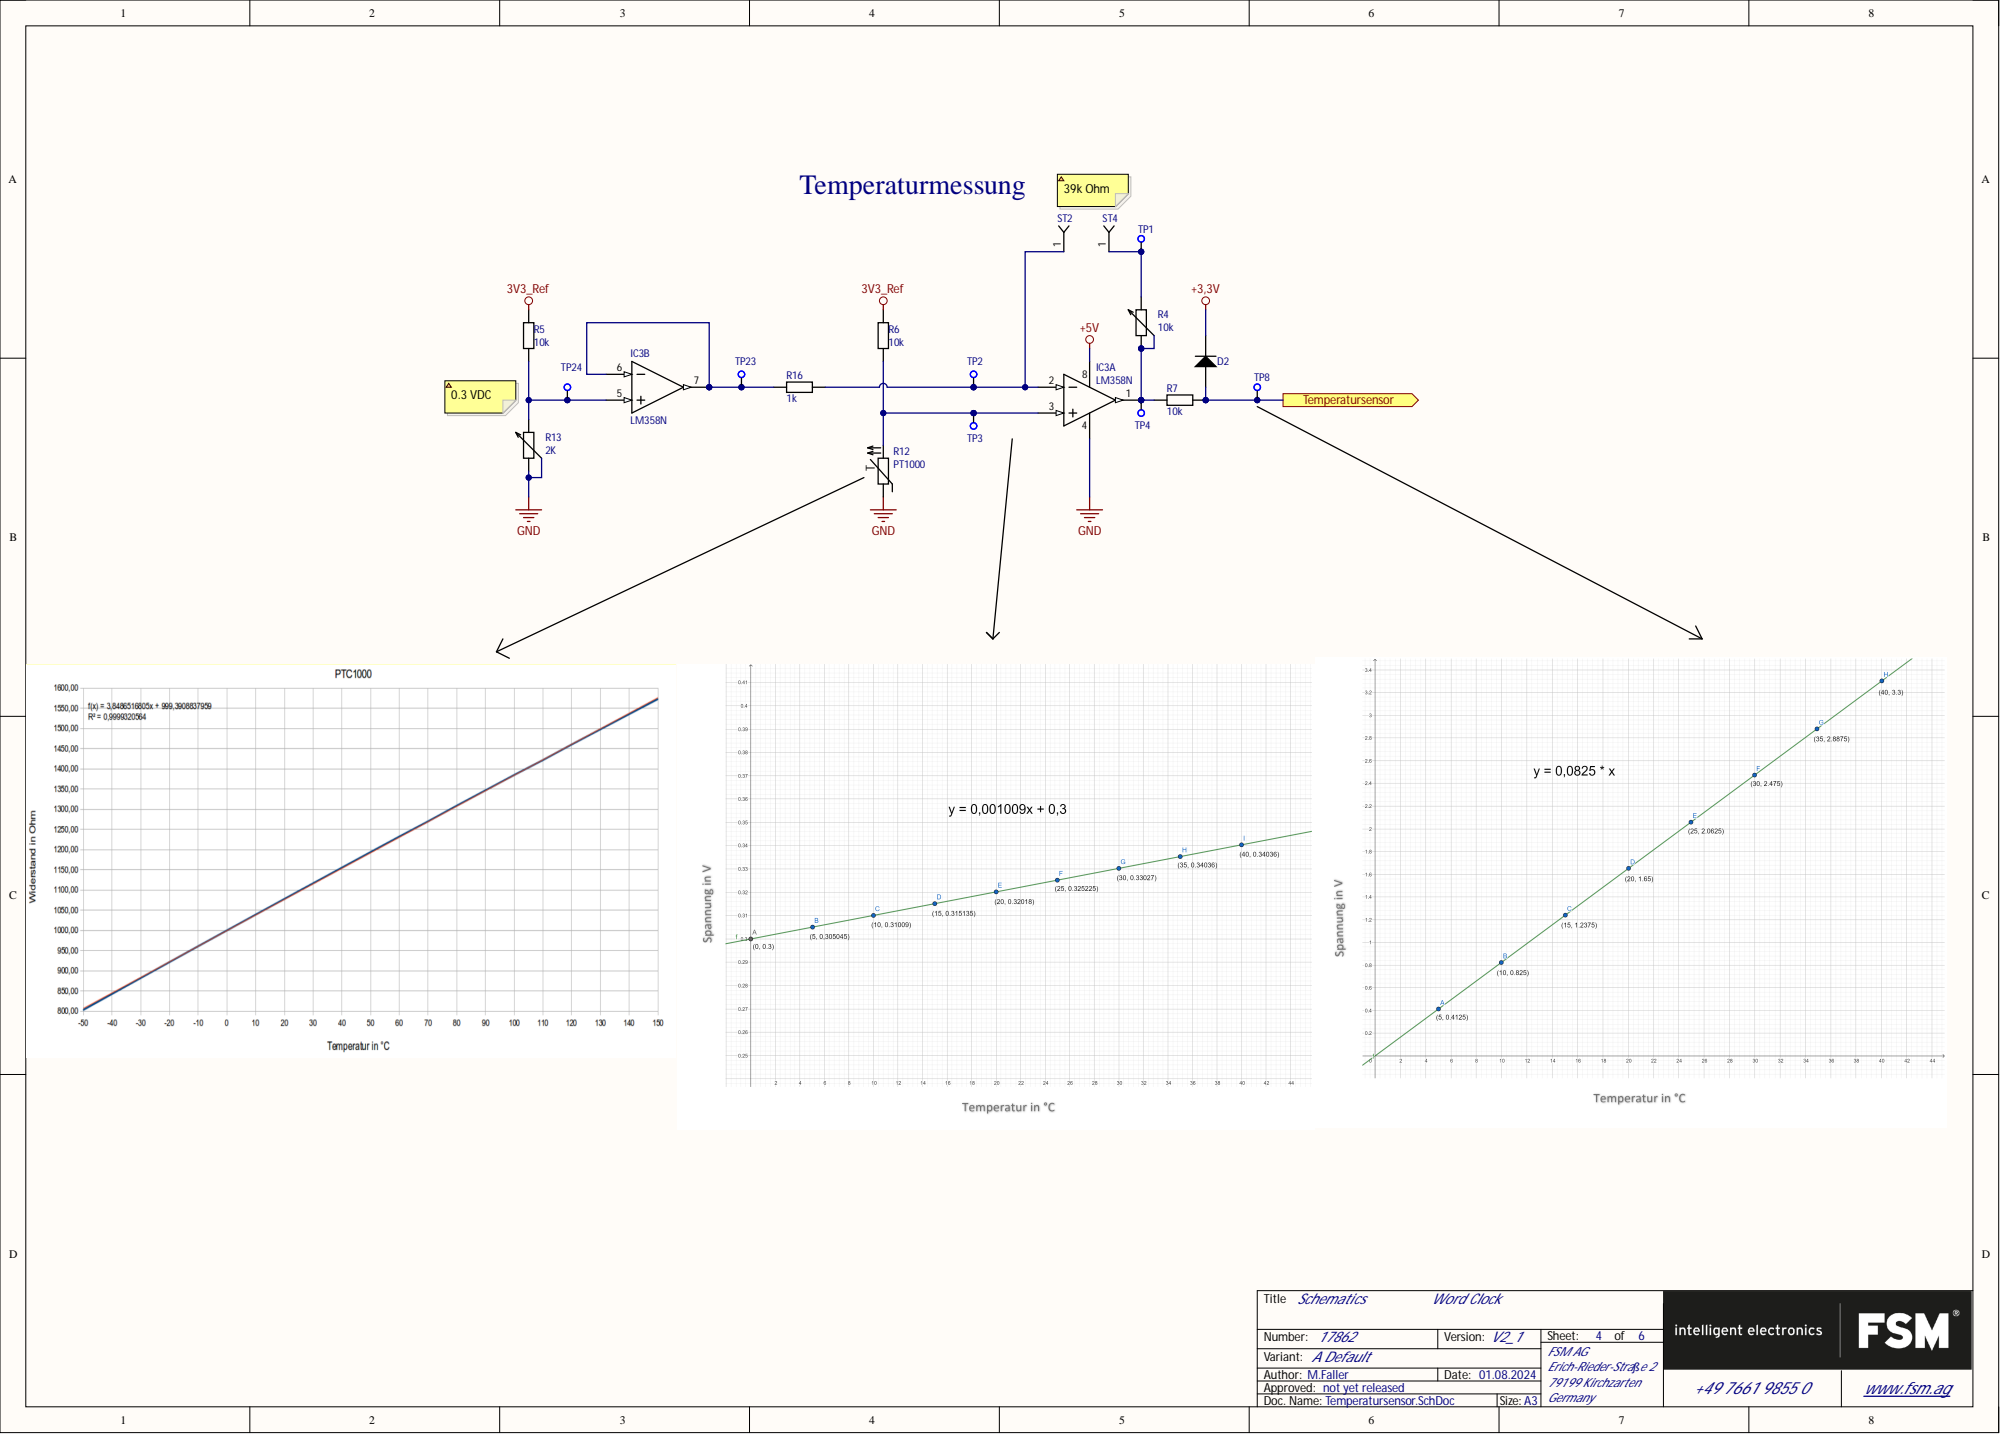
[picture p21: page 4]

Variant:
Author: M.
Approved: not yet re

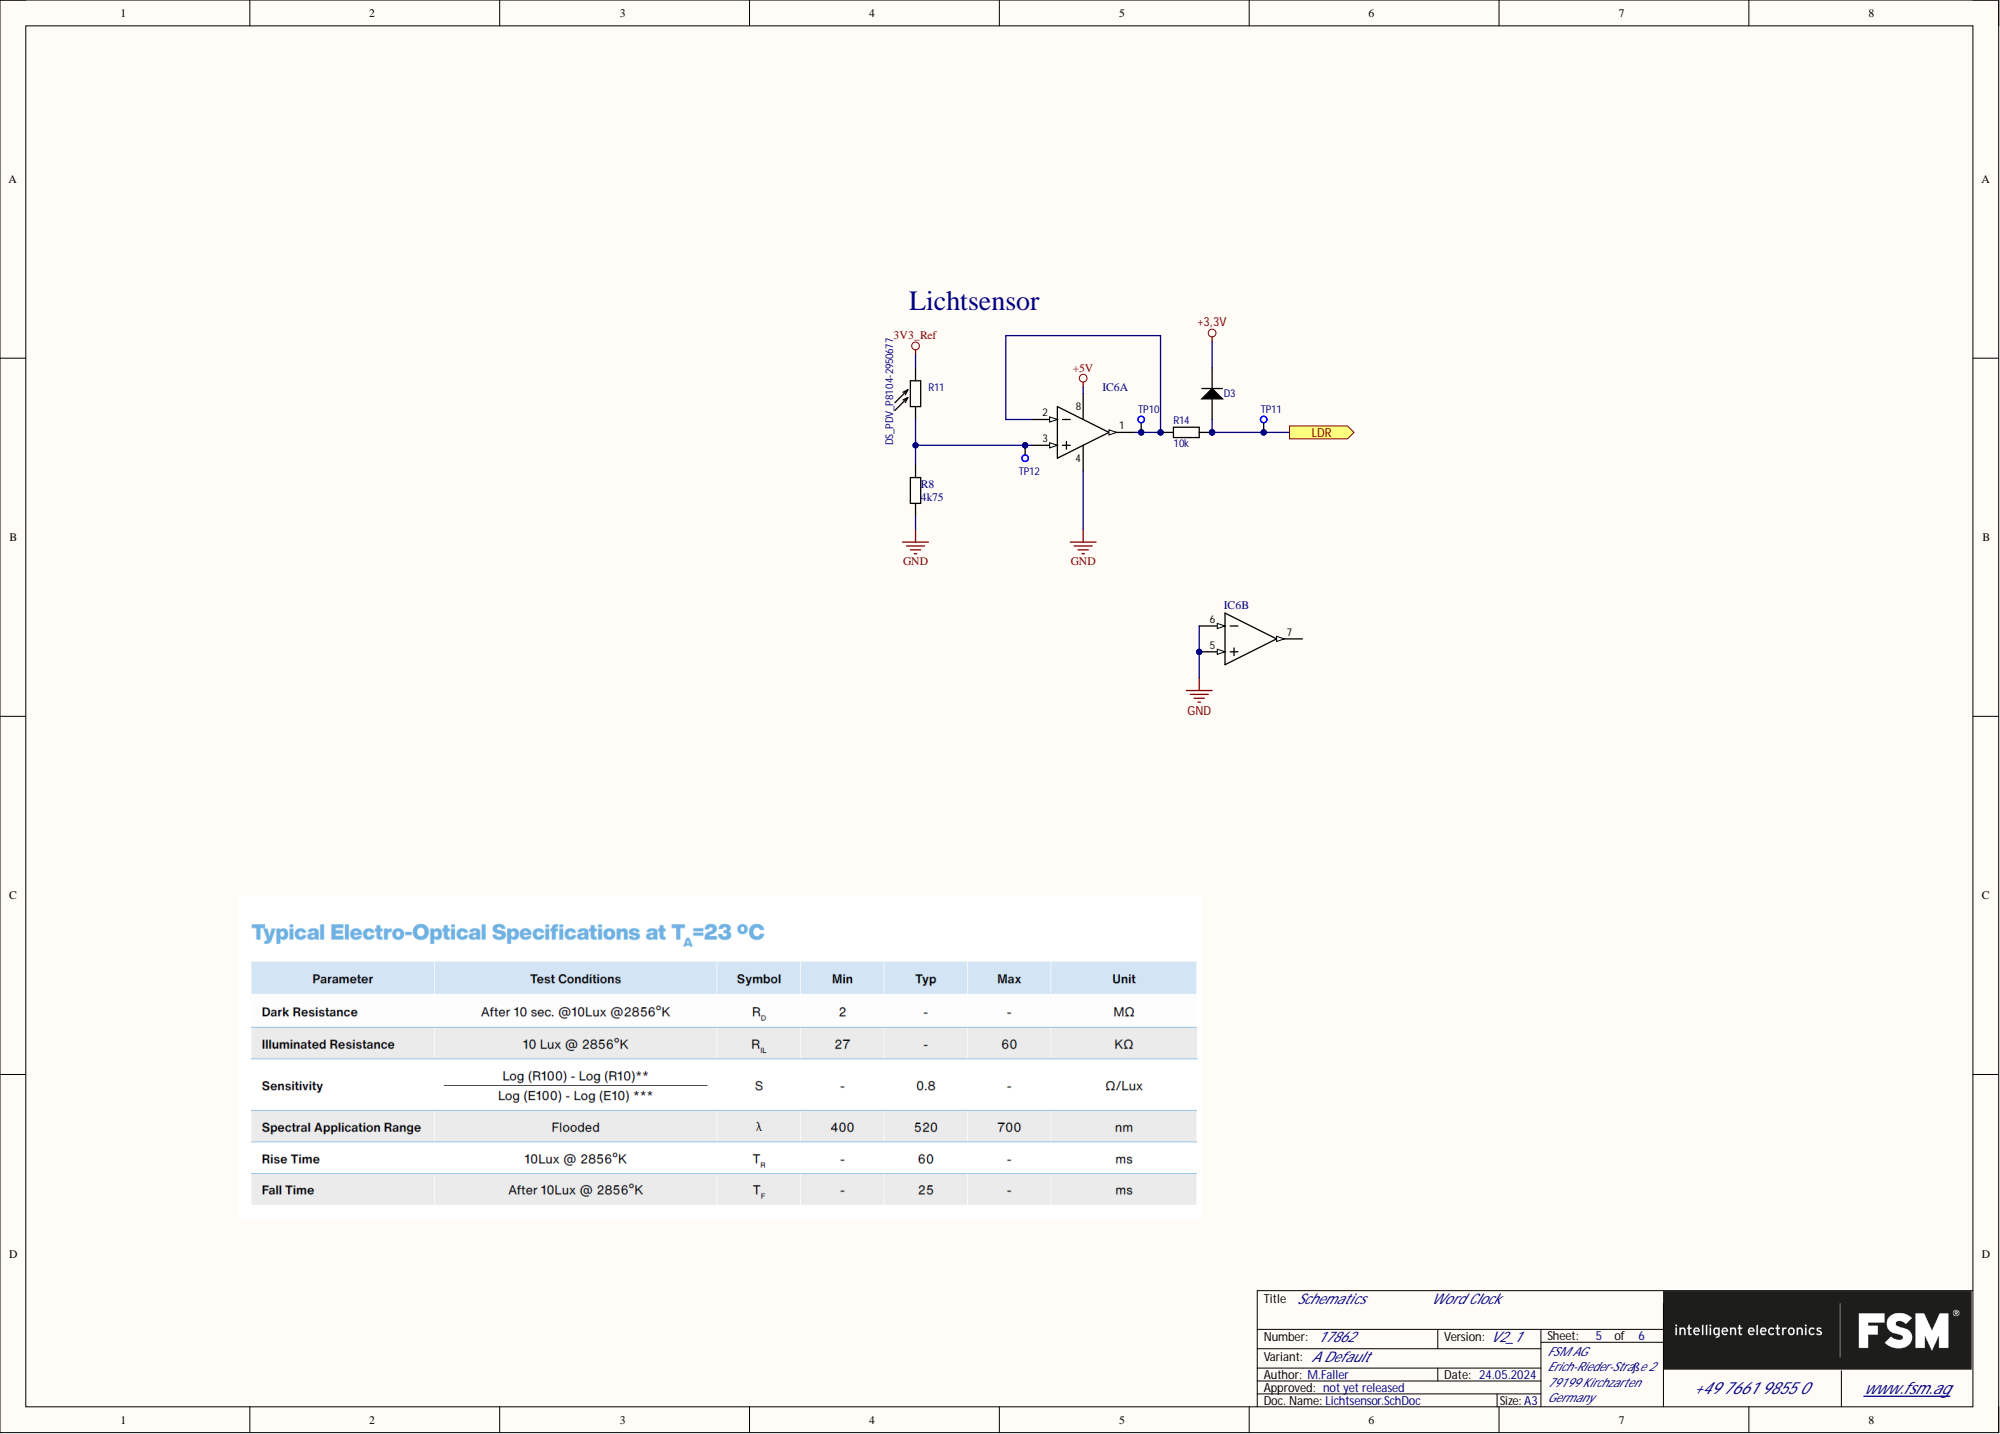
[picture p22: page 5]

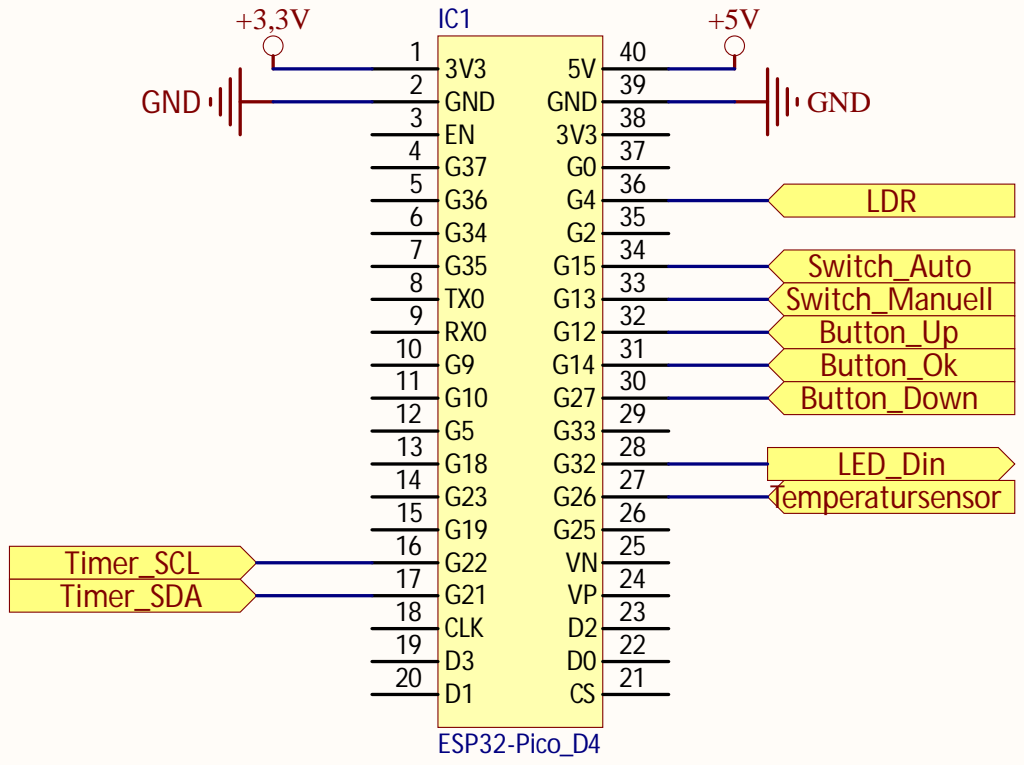
[picture p23: page 6]
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
