StefanSaier-FSM/PowerBors-Wordclock/3_Software/Wordclock/Icons.h

#ifndef Icons_H 
#define Icons_H

#include <stdint.h>

#define NUM_COLUMNS 10    // Anzahl der Spalten (Aufbau der LED Matrix)
#define NUM_ROW 11        // Anzhal der Reihen (Aufbau der LED Matrix)


enum Rotation_e {
  Rotation_0_deg,
  Rotation_180_deg,
  No_Rotation
};

// alle Benötigten Muster werden hier mit 1 und 0 dargestellt. Die LEDs, die leuchten sollen werden mit einer 1 versehen. Die Anderen bleiben bei 0
static bool IconMenuZeitEinstellen[NUM_COLUMNS][NUM_ROW] = {
  { 0, 1, 1, 1, 1, 1, 1, 1, 1, 1, 0 },
  { 0, 1, 1, 1, 1, 1, 1, 1, 1, 1, 0 },
  { 0, 0, 0, 0, 0, 0, 0, 1, 1, 0, 0 },
  { 0, 0, 0, 0, 0, 0, 1, 1, 0, 0, 0 },
  { 0, 0, 0, 0, 0, 1, 1, 0, 0, 0, 0 },
  { 0, 0, 0, 0, 1, 1, 0, 0, 0, 0, 0 },
  { 0, 0, 0, 1, 1, 0, 0, 0, 0, 0, 0 },
  { 0, 0, 1, 1, 0, 0, 0, 0, 0, 0, 0 },
  { 0, 1, 1, 1, 1, 1, 1, 1, 1, 1, 0 },
  { 0, 1, 1, 1, 1, 1, 1, 1, 1, 1, 0 }
};

static bool IconMenuHelligkeitEinstellen[NUM_COLUMNS][NUM_ROW] = {
  { 0, 1, 1, 0, 0, 0, 0, 0, 1, 1, 0 },
  { 0, 1, 1, 0, 0, 0, 0, 0, 1, 1, 0 },
  { 0, 1, 1, 0, 0, 0, 0, 0, 1, 1, 0 },
  { 0, 1, 1, 0, 0, 0, 0, 0, 1, 1, 0 },
  { 0, 1, 1, 1, 1, 1, 1, 1, 1, 1, 0 },
  { 0, 1, 1, 1, 1, 1, 1, 1, 1, 1, 0 },
  { 0, 1, 1, 0, 0, 0, 0, 0, 1, 1, 0 },
  { 0, 1, 1, 0, 0, 0, 0, 0, 1, 1, 0 },
  { 0, 1, 1, 0, 0, 0, 0, 0, 1, 1, 0 },
  { 0, 1, 1, 0, 0, 0, 0, 0, 1, 1, 0 }
};

static bool IconMenuFarbeEinstellen[NUM_COLUMNS][NUM_ROW] = {
  { 0, 1, 1, 1, 1, 1, 1, 1, 0, 0, 0 },
  { 0, 1, 1, 1, 1, 1, 1, 1, 0, 0, 0 },
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
  { 0, 0, 0, 0, 0, 0, 0, 0, 0, 0, 0 },
  { 0, 0, 0, 0, 0, 0, 0, 0, 0, 0, 0 },
  { 0, 0, 0, 0, 0, 0, 0, 0, 0, 0, 0 },
  { 0, 0, 0, 0, 0, 0, 0, 0, 0, 0, 0 },
  { 0, 0, 0, 0, 0, 0, 0, 0, 0, 0, 0 },
  { 0, 0, 0, 0, 0, 1, 1, 1, 1, 0, 0 },
  { 0, 0, 0, 0, 0, 0, 0, 0, 0, 0, 0 }
};

static bool Icon_11_std[NUM_COLUMNS][NUM_ROW] = {
  { 0, 0, 0, 0, 0, 0, 0, 0, 0, 0, 0 },
  { 0, 0, 0, 0, 0, 0, 0, 0, 0, 0, 0 },
  { 0, 0, 0, 0, 0, 0, 0, 0, 0, 0, 0 },
  { 0, 0, 0, 0, 0, 0, 0, 0, 0, 0, 0 },
  { 0, 0, 0, 0, 0, 0, 0, 0, 0, 0, 0 },
  { 0, 0, 0, 0, 0, 0, 0, 0, 0, 0, 0 },
  { 0, 0, 0, 0, 0, 0, 0, 0, 0, 0, 0 },
  { 1, 1, 1, 0, 0, 0, 0, 0, 0, 0, 0 },
  { 0, 0, 0, 0, 0, 0, 0, 0, 0, 0, 0 },
  { 0, 0, 0, 0, 0, 0, 0, 0, 0, 0, 0 }
};

static bool Icon_12_std[NUM_COLUMNS][NUM_ROW] = {
  { 0, 0, 0, 0, 0, 0, 0, 0, 0, 0, 0 },
  { 0, 0, 0, 0, 0, 0, 0, 0, 0, 0, 0 },
  { 0, 0, 0, 0, 0, 0, 0, 0, 0, 0, 0 },
  { 0, 0, 0, 0, 0, 0, 0, 0, 0, 0, 0 },
  { 0, 0, 0, 0, 0, 1, 1, 1, 1, 1, 0 },
  { 0, 0, 0, 0, 0, 0, 0, 0, 0, 0, 0 },
  { 0, 0, 0, 0, 0, 0, 0, 0, 0, 0, 0 },
  { 0, 0, 0, 0, 0, 0, 0, 0, 0, 0, 0 },
  { 0, 0, 0, 0, 0, 0, 0, 0, 0, 0, 0 },
  { 0, 0, 0, 0, 0, 0, 0, 0, 0, 0, 0 }
};

void addPixelArrayToArray(bool firstIconPointer[][NUM_ROW], bool secondIconPointer[][NUM_ROW]);
void clearIconArray(bool IconPointer[][NUM_ROW]);
void setIconFullScreen(bool Icon[NUM_COLUMNS][NUM_ROW], uint32_t onColor, uint32_t offColor, Rotation_e rotation);

#endif
