StefanSaier-FSM/PowerBors-Wordclock/(commit log)

2024-08-01 - Ordnerstruktur angelegt - PCB V2 Daten hinzugefügt
    [17862V2 STL Component Calculation.xlsx, 17862V2 STL Component Release.xlsx, 17862V2 STL SMT.xlsx, 17862V2 STL THT.xlsx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]
2024-08-01 Software und Konstruktion hinzugefügt
    [Abschirmung LED's 200x200mm 12H.stp, Abschirmung LED's.stp, Frontplatte mit Stegen.stp, Gehäuseunterteil 200x200mm 12H.stp, Gehäuseunterteil.stp, LED's Wordclock 200x200mm 12H.stp, Milchglas.stp, Wordclock_200x200mm_12H.stp]
2024-08-01 Datenblätter der verwendetetn Komponenten hinzugefügt
2024-09-30 Bugfix: - Es wurde ein Fehler behoben, wodurch Die Uhr im Hintergrund nicht weiter gezählt hat, wenn man im Menü war. - Es wurde ein Fehler behoben, wodruch ein beim übergang von 12 Uhr auf 13(1) Uhr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
    [Icons.h, Wordclock.ino]
2024-10-10 - Ein Fehler wurde behoben durch welchen die Zeiten größer 12 Uhr flasch dargestellt wurden - Die darstellung von xx:40 bis xx:44 ist jetzt "20 vor" andtelle von "15 nach halb"
    [Wordclock.ino]
2024-10-16 Bedienungsanleitung und Label hinzugefügt
